ProD-byte/Roboauto/Codes/roboauto_finalv5/Claude outputs/seite.png

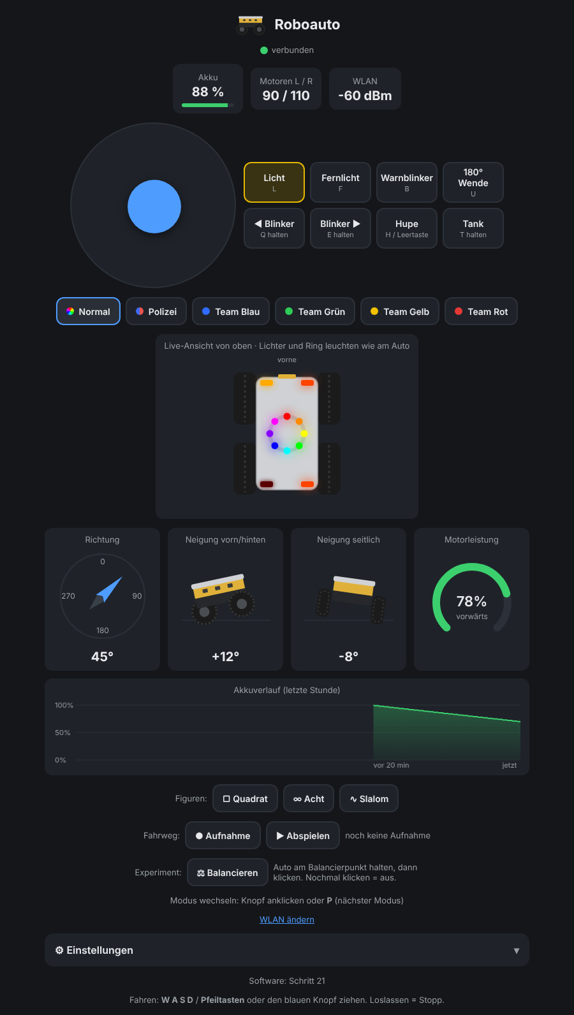
Codes/roboauto_finalv5/Claude outputs/seite.png
