ProD-byte/Roboauto/Codes/roboauto_finalv5/Claude outputs/vergleich.png

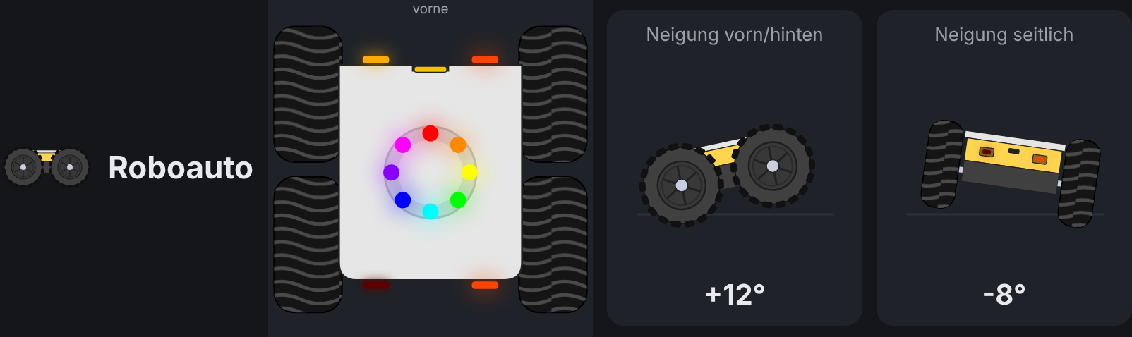
Codes/roboauto_finalv5/Claude outputs/vergleich.png
