ProD-byte/Roboauto/Codes/roboauto_pio/docs/bilder/web-jukebox.jpg

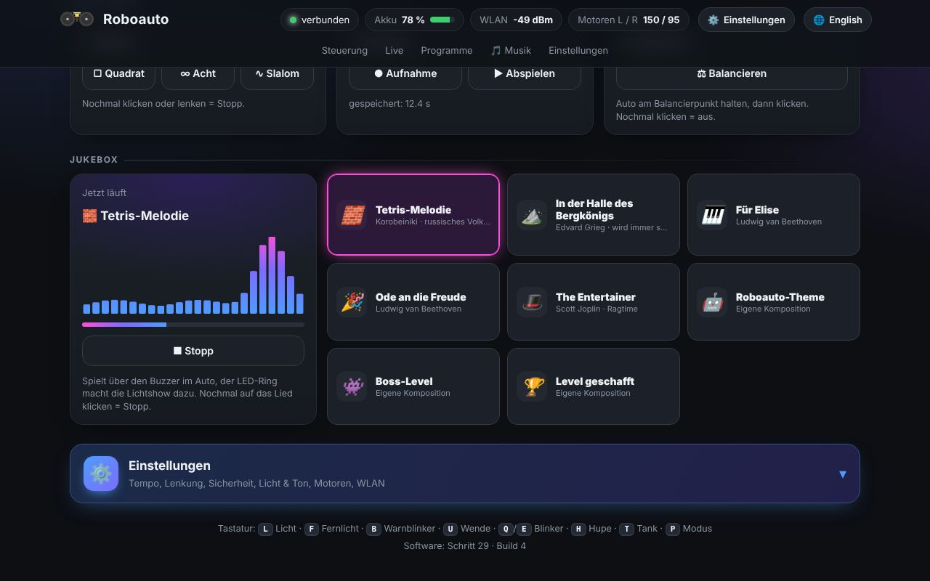
Codes/roboauto_pio/docs/bilder/web-jukebox.jpg
