ProD-byte/Roboauto/Codes/roboauto_pio/docs/bilder/web-live.jpg

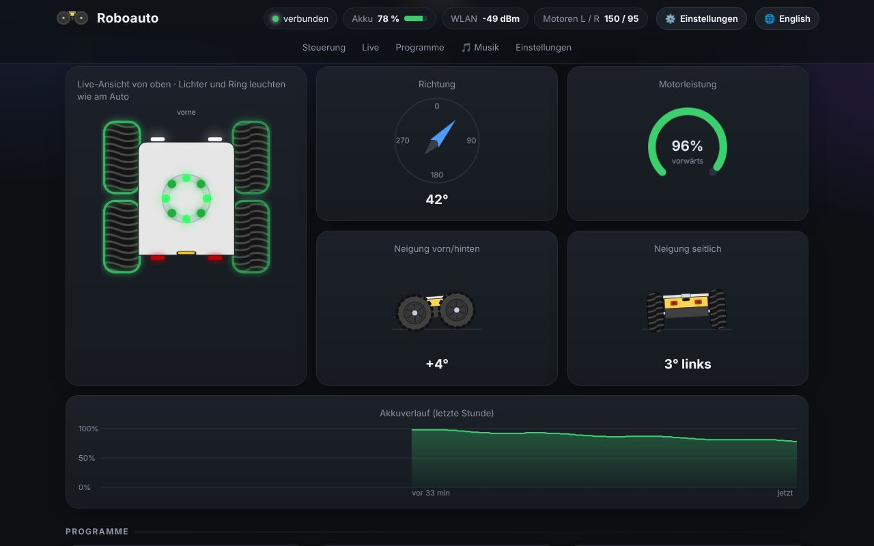
Codes/roboauto_pio/docs/bilder/web-live.jpg
