ProD-byte/Roboauto/Render1.png

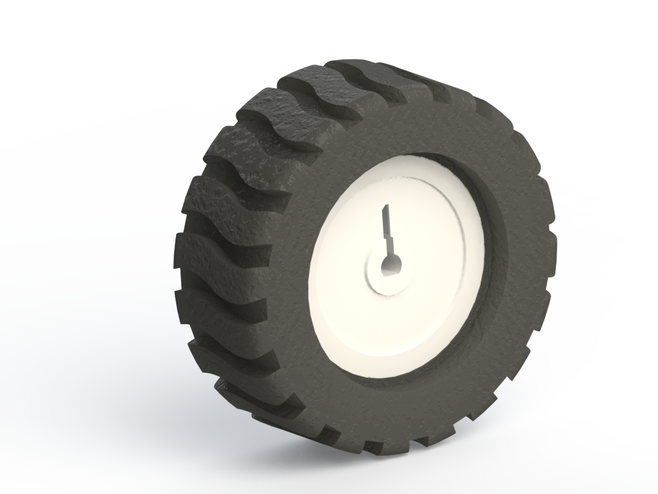
Render1.png
