ProD-byte/Roboauto/Render2.png

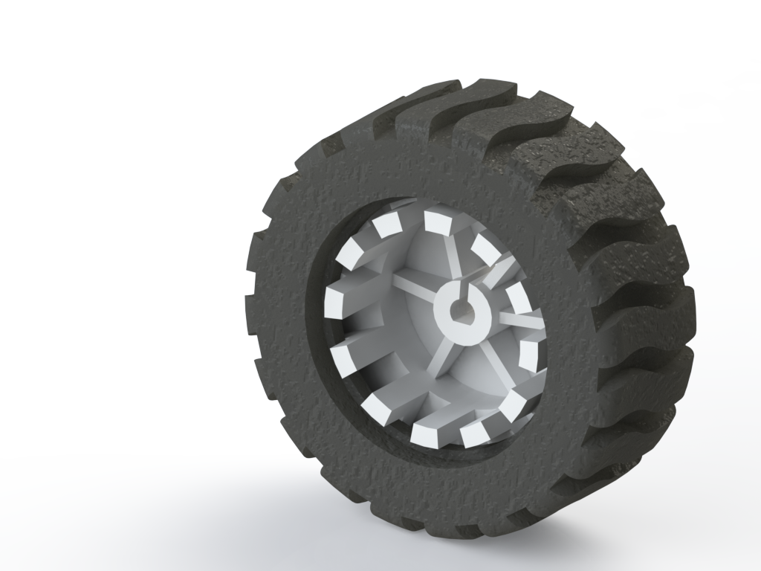
Render2.png
