ProD-byte/Roboauto/3D-Druck/alte Versionen/Roboauto Wanne.stl

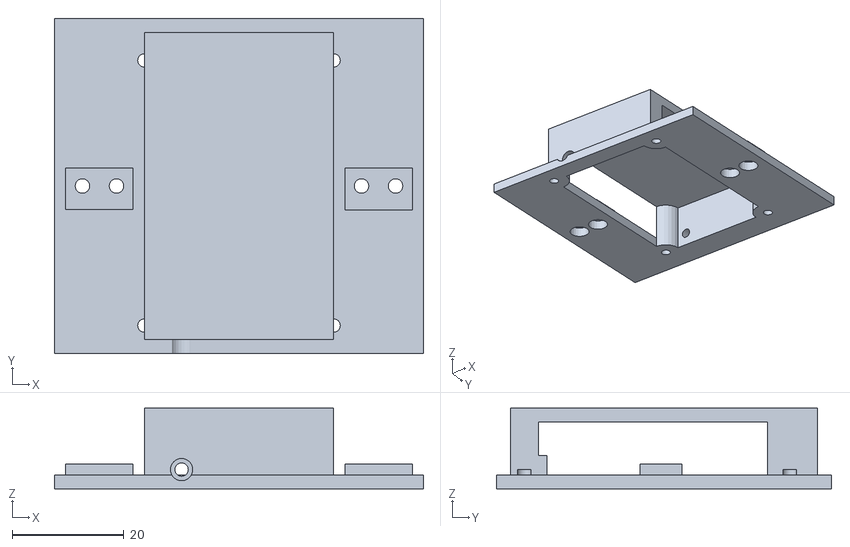
[picture p8: CAD file, 2026-10-28]
3D-Druck/alte Versionen/Roboauto Wanne.stl
66.1 x 60.0 x 14.5
