ProD-byte/Roboauto/3D-Druck/Roboauto Wanne V4.stl

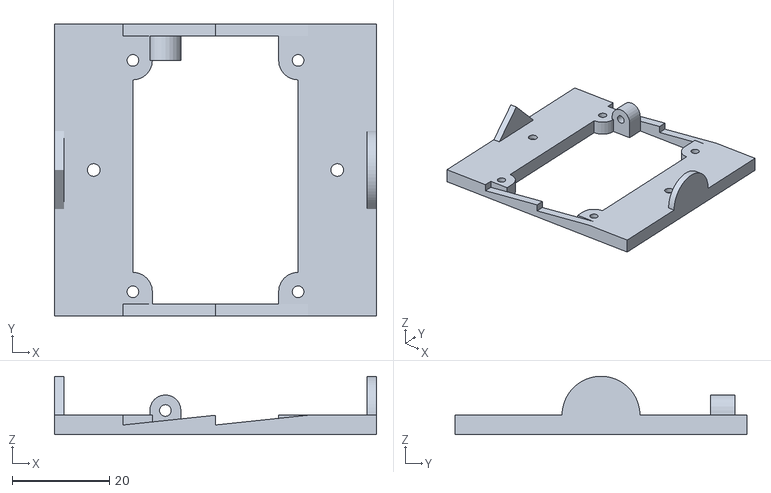
[picture p9: CAD file, 2026-10-28]
3D-Druck/Roboauto Wanne V4.stl
66.1 x 60.0 x 12.0
