ProD-byte/Roboauto/Roboauto Oberteil.stl

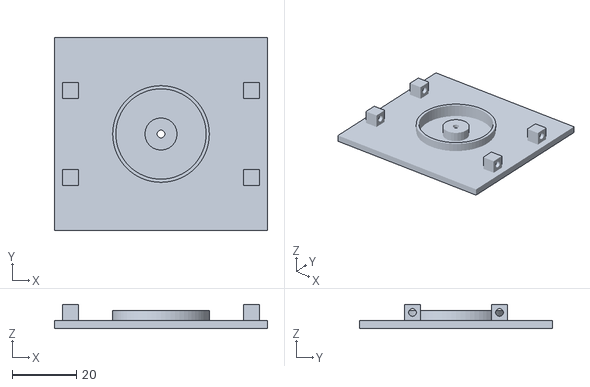
[picture p10: CAD file, 2026-10-27]
Roboauto Oberteil.stl
66.1 x 60.0 x 7.50
