ProD-byte/Roboauto/Roboauto Schalter HalterV1.stl

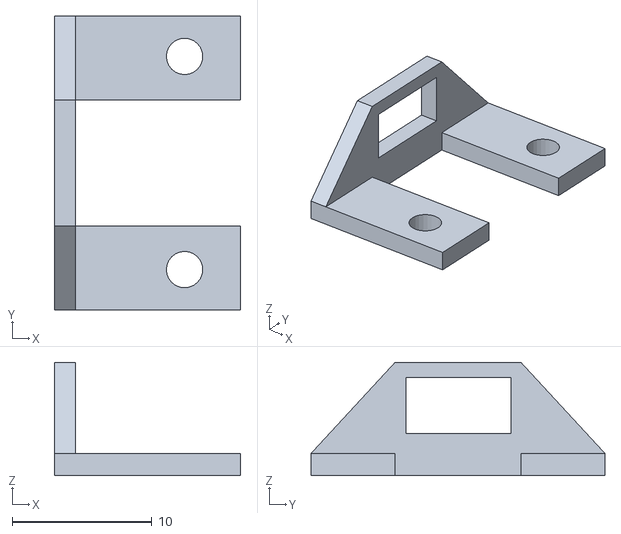
[picture p11: CAD file, 2026-10-27]
Roboauto Schalter HalterV1.stl
13.3 x 21.0 x 8.10
