ProD-byte/Roboauto/Roboauto Kugel.stl

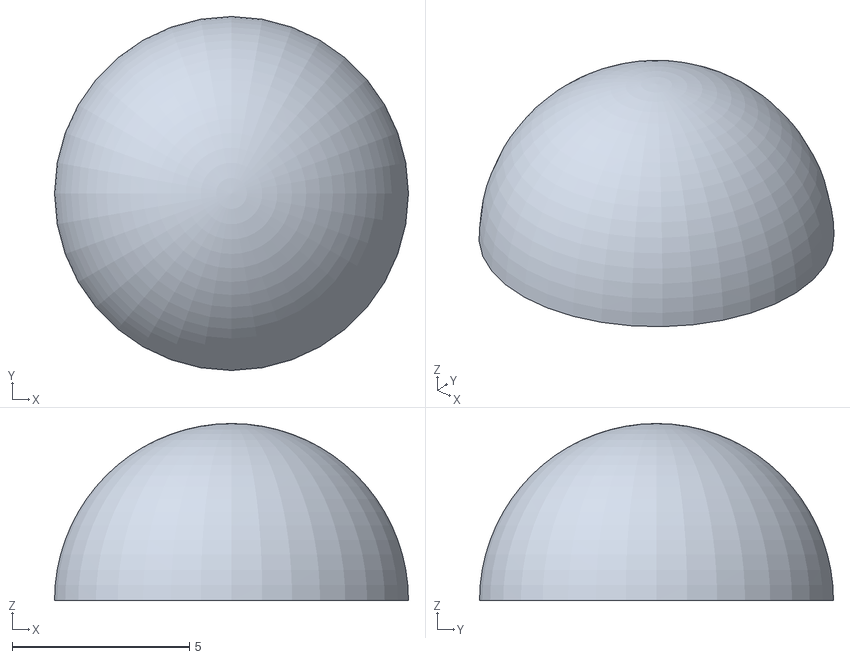
[picture p12: CAD file, 2026-10-27]
Roboauto Kugel.stl
10.0 x 10.00 x 5.00
