ProD-byte/Roboauto/Roboauto Wanne V2.stl

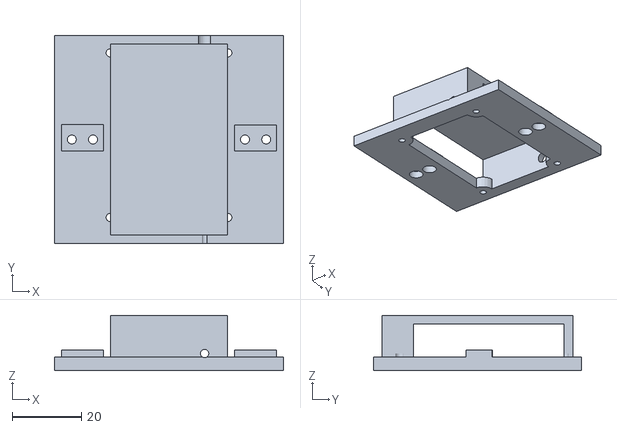
[picture p13: CAD file, 2026-10-27]
Roboauto Wanne V2.stl
66.1 x 60.0 x 16.0
