ProD-byte/Roboauto/Roboauto Ledrinhalter.stl

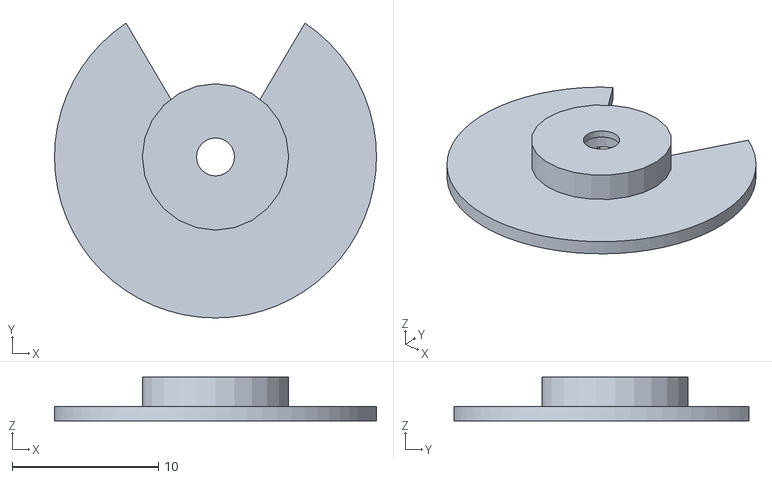
[picture p14: CAD file, 2026-10-27]
Roboauto Ledrinhalter.stl
22.0 x 20.1 x 3.00
