ProD-byte/Roboauto/Roboauto UnterteilV5.stl

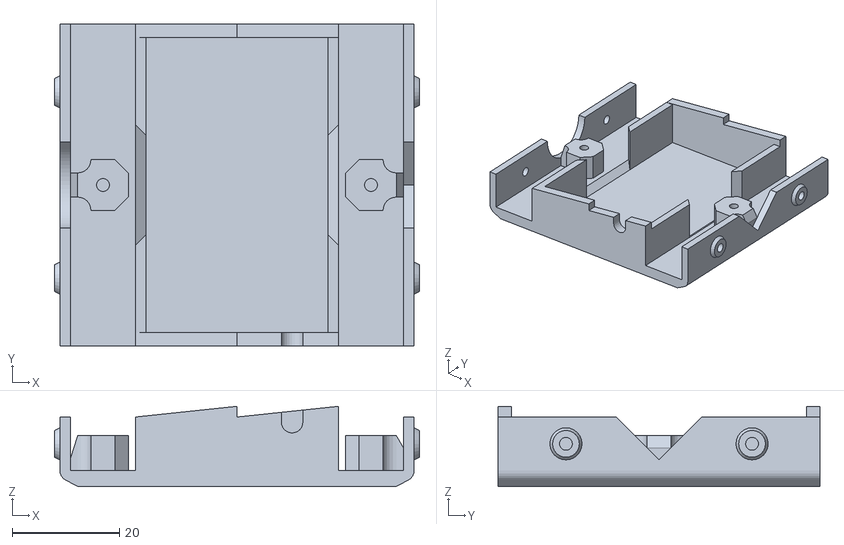
[picture p15: CAD file, 2026-10-27]
Roboauto UnterteilV5.stl
68.1 x 60.0 x 15.0
