ProD-byte/Roboauto/Roboauto Brücke.stl

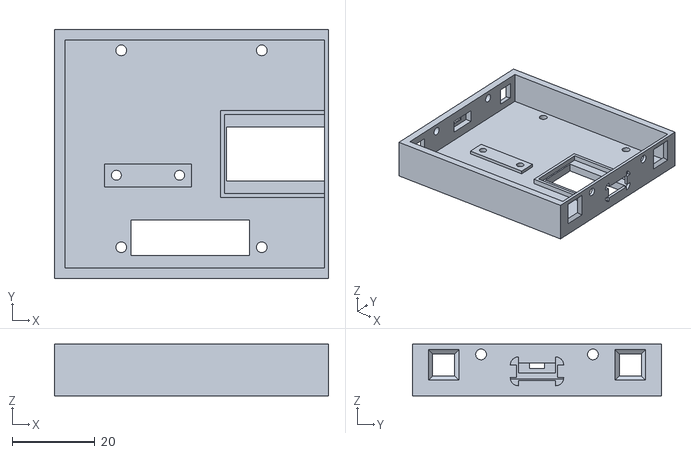
[picture p16: CAD file, 2026-10-27]
Roboauto Brücke.stl
66.1 x 60.0 x 12.5
