ProD-byte/Roboauto/Roboauto Unterteil.stl

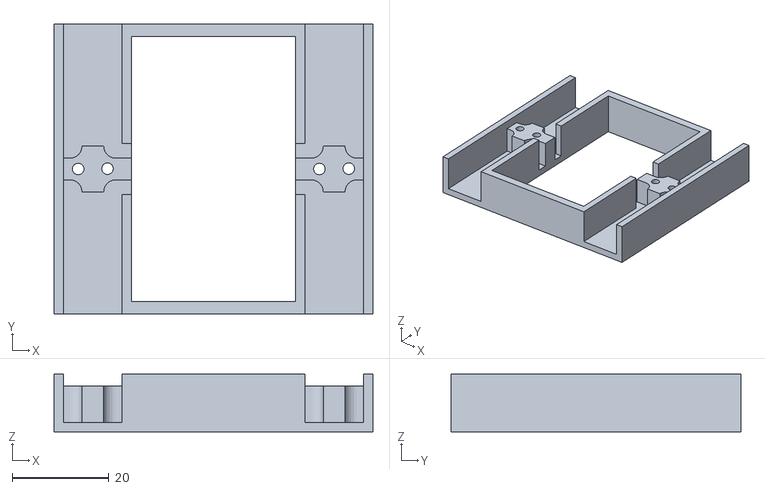
[picture p17: CAD file, 2026-10-27]
Roboauto Unterteil.stl
66.1 x 60.0 x 12.0
