ProD-byte/Roboauto/Roboauto Brücke V6.stl

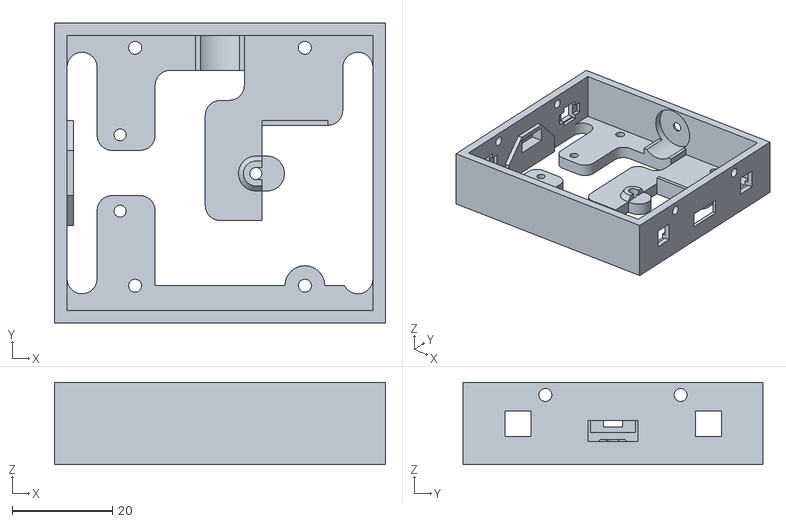
[picture p18: CAD file, 2026-10-27]
Roboauto Brücke V6.stl
66.1 x 60.0 x 16.4
