ProD-byte/Roboauto/Roboauto Brücke V2.stl

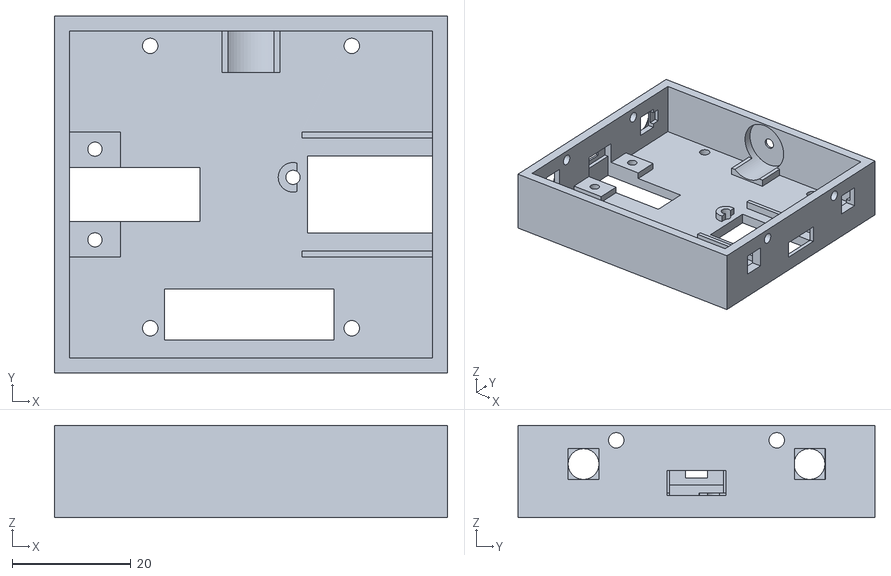
[picture p19: CAD file, 2026-10-27, an earlier design]
Roboauto Brücke V2.stl
66.1 x 60.0 x 15.5
