ProD-byte/Roboauto/(list of files, cad)

Other CAD files:
Roboauto Oberteil 32mm Ledring.stl
3D-Druck/Roboauto Brücke V6.skp
3D-Druck/Roboauto Kugel.skp
3D-Druck/Roboauto Ledrinhalter.skp
3D-Druck/Roboauto UnterteilV5.skp
3D-Druck/Roboauto WanneV4.skp
3D-Druck/alte Versionen/Roboauto Brücke V5.skp
3D-Druck/alte Versionen/Roboauto Brücke.skp
3D-Druck/alte Versionen/Roboauto Oberteil 32mm Ledring.skp
3D-Druck/alte Versionen/Roboauto Unterteil V3.skp
3D_PCB_PCB_RoboAutoPlatine_2026-09-26_2026-09-26.skp
Modell/Roboauto Version 6.skp
Platine/OBJ_PCB_RoboAutoPlatine.skp
Robo Auto Platine.skp
Roboauto Brücke V2.skp
Roboauto Brücke V3.skp
Roboauto Brücke V4.skp
Roboauto Oberteil 28mm Ledring.skp
Roboauto Oberteil 32mm Ledring V.2.skp
Roboauto Oberteil.skp
Roboauto Schalter HalterV1.skp
Roboauto Unterteil V2.skp
Roboauto Unterteil V5.skp
Roboauto Unterteil.skp
Roboauto UnterteilV4.skp
Roboauto UnterteilV5 1.skp
Roboauto Version Platine.skp
Roboauto Wanne V2.skp
Roboauto Wanne V3.skp
Roboauto Wanne.skp
