ProD-byte/Roboauto/Platine/Schaltplan_XIAO_ESP32-C6.pdf

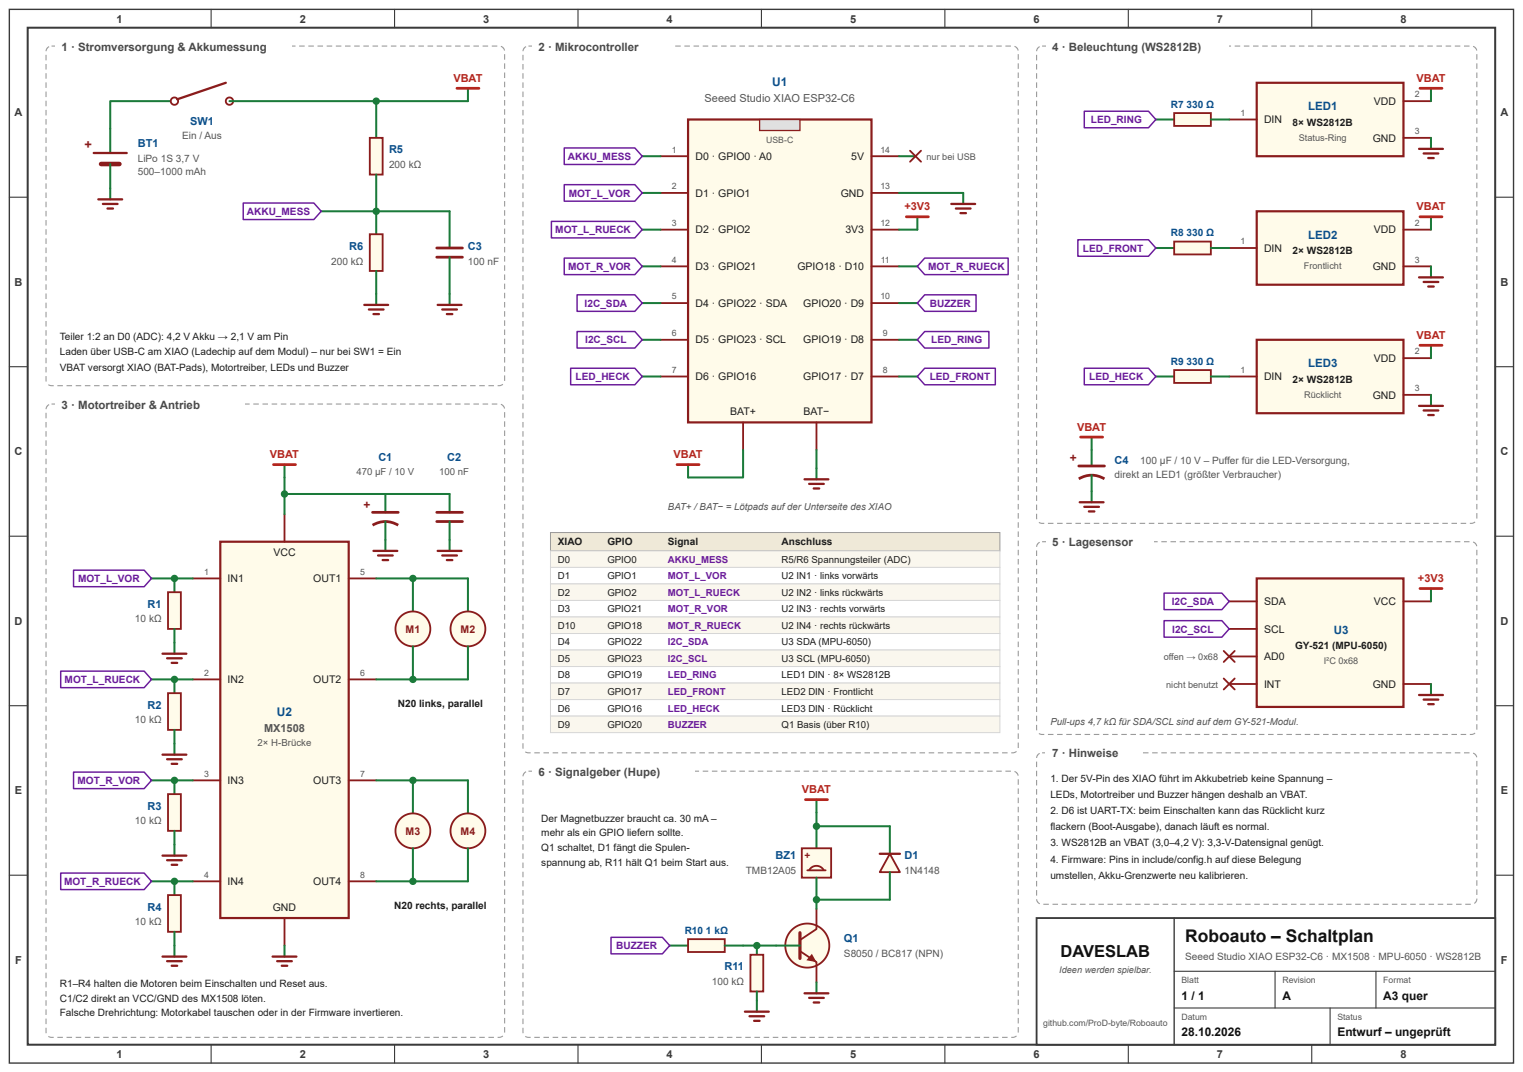
[picture p20: page 1]

Teiler 1:2 an D0 (ADC): 4,2 V Akku → 2,1 V am Pin
Laden über USB-C am XIAO (Ladechip auf dem Modul) – nur bei SW1 = Ein
VBAT versorgt XIAO (BAT-Pads), Motortreiber, LEDs und Buzzer

direkt an LED1 (größter Verbraucher)

BAT+ / BAT− = Lötpads auf der Unterseite des XIAO

Pull-ups 4,7 kΩ für SDA/SCL sind auf dem GY-521-Modul.

1. Der 5V-Pin des XIAO führt im Akkubetrieb keine Spannung –
LEDs, Motortreiber und Buzzer hängen deshalb an VBAT.
2. D6 ist UART-TX: beim Einschalten kann das Rücklicht kurz
flackern (Boot-Ausgabe), danach läuft es normal.
3. WS2812B an VBAT (3,0–4,2 V): 3,3-V-Datensignal genügt.
4. Firmware: Pins in include/config.h auf diese Belegung
umstellen, Akku-Grenzwerte neu kalibrieren.

Der Magnetbuzzer braucht ca. 30 mA –
mehr als ein GPIO liefern sollte.
Q1 schaltet, D1 fängt die Spulen-
spannung ab, R11 hält Q1 beim Start aus.

Seeed Studio XIAO ESP32-C6 · MX1508 · MPU-6050 · WS2812B

R1–R4 halten die Motoren beim Einschalten und Reset aus.
C1/C2 direkt an VCC/GND des MX1508 löten.
Falsche Drehrichtung: Motorkabel tauschen oder in der Firmware invertieren.

github.com/ProD-byte/Roboauto
