ProD-byte/Roboauto/Codes/roboauto_pio/include/config.h

#pragma once
// ============================================================
//  Zentrale Einstellungen: Pins und Fahrwerte
//
//  Board: Seeed Studio XIAO ESP32S3 Sense (Umgebung roboauto_xiao bzw. roboauto_xiao_wlan)
//
//  Pins:
//  Pin   GPIO  Funktion
//  D0    1     Motor links vor
//  D1    2     Motor links rueck
//  D2    3     Motor rechts vor
//  D3    4     Motor rechts rueck
//  D4    5     I2C SDA  (MPU6050 + Akkuwaechter)
//  D5    6     I2C SCL  (MPU6050 + Akkuwaechter)
//  D6    43    Buzzer
//  D7    44    LED-Kette DIN (Ring -> Front -> Heck)
//  D8-10 7-9   SD-Karte (SPI, auf dem Sense-Board, CS = GPIO21)
//  intern      Kamera (OV5640/OV3660/OV2640), Mikrofon (PDM: GPIO42 Takt, GPIO41 Daten)
// ============================================================

// --- Motoren (H-Bruecke) ---
constexpr int MOTOR_L_VOR    = 1;    // D0
constexpr int MOTOR_L_RUECK  = 2;    // D1
constexpr int MOTOR_R_VOR    = 3;    // D2
constexpr int MOTOR_R_RUECK  = 4;    // D3

// Drehrichtung je Motor umkehren, falls er falsch herum angeschlossen ist.
// Im Fahrtest ermittelt: der rechte Motor laeuft "verkehrt herum".
constexpr bool MOTOR_L_INVERTIERT = false;
constexpr bool MOTOR_R_INVERTIERT = false;   // neue Autos: nichts umgekehrt - per Assistent einstellen
// (Startwerte - auf der Webseite unter Einstellungen > Motoren aenderbar)
constexpr int  MOTORTEST_TEMPO = 120;     // Motortest: Staerke
constexpr unsigned long MOTORTEST_MS = 1500;   // Motortest: Dauer

// --- Weitere Pins ---
// Buzzer auf GPIO43 (TX): beim Einschalten schickt der Chip kurz seine Startmeldung dorthin,
// das gibt hoechstens ein leises Rauschen. Auf GPIO44 (RX) haetten die LEDs dabei wild geflackert.
constexpr int BUZZER_PIN     = 43;   // D6
constexpr int LED_KETTE_PIN  = 44;   // D7: alle WS2812 an EINEM Pin
constexpr int GYRO_SDA_PIN   = 5;    // D4 (I2C fuer Gyro und Akkuwaechter)
constexpr int GYRO_SCL_PIN   = 6;    // D5

// --- LED-Ring ---
constexpr int LED_RING_ANZAHL     = 8;
constexpr int LED_RING_HELLIGKEIT = 40;   // 0..255 (wie in V5)

// --- Front- und Ruecklichter (je 2 NeoPixel) ---
constexpr int FRONT_LED_ANZAHL   = 2;
constexpr int REAR_LED_ANZAHL    = 2;
// Nummern in der LED-Kette (siehe ledkette.h): 0..7 = Ring, 8..9 = Front, 10..11 = Heck.
// XIAO: Data geht in den Ring, von dessen DOUT weiter zu den Frontlichtern, von dort zu den Ruecklichtern.
constexpr int LED_KETTE_RING     = 0;                                   // erste LED des Rings
constexpr int LED_KETTE_FRONT    = LED_KETTE_RING + LED_RING_ANZAHL;    // erste Front-LED
constexpr int LED_KETTE_REAR     = LED_KETTE_FRONT + FRONT_LED_ANZAHL;  // erste Heck-LED
constexpr int LED_KETTE_ANZAHL   = LED_KETTE_REAR + REAR_LED_ANZAHL;
constexpr int LICHT_HELLIGKEIT   = 40;    // 0..255 (wie in V5)
constexpr int REAR_LED_RUECKFAHR = 1;     // diese Ruecklicht-LED wird beim Rueckwaertsfahren weiss

// Farben (wie in V5)
constexpr uint32_t FARBE_FAHRLICHT  = 0x966400;  // gelb, stromsparend
constexpr uint32_t FARBE_FERNLICHT  = 0xFFFFFF;  // weiss
constexpr uint32_t FARBE_RUECKLICHT = 0x1E0000;  // rot gedimmt
constexpr uint32_t FARBE_BREMSLICHT = 0xFF0000;  // rot hell
constexpr uint32_t FARBE_RUECKFAHR  = 0xC8C8C8;  // weiss
constexpr uint32_t FARBE_AUS        = 0x000000;

// Welche LED ist links? (0 oder 1) - die andere ist automatisch rechts
constexpr int FRONT_LED_LINKS = 0;
constexpr int REAR_LED_LINKS  = 0;

constexpr uint32_t FARBE_BLINKER    = 0xE63C00;  // orange

constexpr unsigned long BREMSLICHT_DAUER = 400;  // ms
constexpr unsigned long BLINK_TAKT       = 250;  // ms an / ms aus

// --- Hupe ---
constexpr int HUPE_FREQUENZ = 300;               // Hz (wie V5)

// --- Licht-Modi (Knoepfe in App/Webseite) ---
enum Modus { MODUS_NORMAL = 0, MODUS_POLIZEI, MODUS_BLAU, MODUS_GRUEN, MODUS_GELB, MODUS_ROT, MODUS_ANZAHL };
constexpr const char* MODUS_NAME[MODUS_ANZAHL] = { "Normal", "Polizei", "Team Blau", "Team Gruen", "Team Gelb", "Team Rot" };

// Teams: Grundfarbe (Farbton 0..65535) und wie weit der Farbton hin- und herschwingt
//                                   Normal Polizei  Blau    Gruen   Gelb   Rot
constexpr uint16_t TEAM_FARBTON[MODUS_ANZAHL] = { 0, 0,     40000,  21000,  9500,  0     };
constexpr uint16_t TEAM_SCHWANK[MODUS_ANZAHL] = { 0, 0,      4000,   7000,  2000,  2200  };
constexpr int      TEAM_HUPE_HZ[MODUS_ANZAHL] = { HUPE_FREQUENZ, 0, 600, 1200, 900, 450 };   // eigener Hupenton je Team

// --- Polizei-Modus ---
constexpr int SIRENE_MIN_HZ = 600;
constexpr int SIRENE_MAX_HZ = 1400;
constexpr unsigned long SIRENE_RUNDE_MS = 400;   // einmal hoch und runter (kleiner = hektischer)
constexpr unsigned long DOPPELKLICK_ZEIT = 350;  // ms

// --- Akku: Akkuwaechter MAX17048 am I2C-Bus (misst Spannung und Ladestand in %) ---
constexpr uint8_t AKKU_ADRESSE  = 0x36;
constexpr int AKKU_ECO_AN       = 15;   // Prozent - darunter: Eco-Modus an
constexpr int AKKU_ECO_AUS      = 20;   // Prozent - darueber: Eco-Modus wieder aus (Hysterese)
constexpr float AKKU_LAEDT_RATE = 1.0f; // %/Stunde - steigt der Ladestand schneller, haengt USB dran
constexpr unsigned long AKKU_VERLAUF_MS = 10000;   // alle 10 s ein Wert fuer das Diagramm
constexpr int AKKU_VERLAUF_PUNKTE      = 360;     // 360 x 10 s = 1 Stunde

// --- Gyroskop (MPU6050) ---
constexpr uint8_t GYRO_ADRESSE        = 0x68;
constexpr int     GYRO_KALIBRIER_MESSUNGEN = 200;   // x 5 ms = 1 Sekunde stillhalten

// --- Fahrwerte ---
constexpr int JOYSTICK_MAX    = 7;    // Joystick in App/Webseite liefert -7 ... +7
constexpr int TOTZONE         = 1;    // |Wert| <= 1 gilt als Mitte
constexpr int PWM_MAX         = 255;  // technische Obergrenze der Motoren
constexpr int MAX_TEMPO       = 128;  // Fahrgeschwindigkeit: 128 = halb so schnell wie frueher (255 = voll)
constexpr int MAX_LENKUNG     = 75;   // Lenkstaerke waehrend der Fahrt (halbiert, frueher 150)
constexpr int MAX_LENKUNG_STAND = 140; // Lenkstaerke beim Drehen auf der Stelle - braucht viel Kraft,
                                       // weil die Reifen seitlich rutschen muessen (Panzerlenkung).
                                       // Dazwischen wird fliessend uebergeblendet.


// --- Geradeauslauf mit Gyro ---
// Faehrt das Auto ohne Lenkbefehl, haelt das Gyro die Richtung.
constexpr bool  GERADEAUS_AKTIV     = true;
constexpr float GERADEAUS_KP        = 4.0f;   // Korrektur pro Grad Abweichung
constexpr float GERADEAUS_KD        = 0.5f;   // Daempfung pro Grad/s Drehrate
constexpr int   GERADEAUS_MAX_KORR  = 80;     // maximale Korrektur (von 255)

// --- 180-Grad-Wende (X doppelt klicken) ---
constexpr float WENDE_WINKEL      = 180.0f;  // Grad, links herum
constexpr int   WENDE_TEMPO_MAX   = 180;     // Drehtempo am Anfang
constexpr int   WENDE_TEMPO_MIN   = 110;     // langsamstes Drehtempo kurz vor dem Ziel
constexpr float WENDE_BREMS_BEREICH = 45.0f; // ab so vielen Grad vor dem Ziel langsamer werden
constexpr float WENDE_TOLERANZ    = 4.0f;    // Grad: so nah reicht als "fertig"
constexpr float WENDE_VORHALT     = 0.10f;   // s: so lange rollt das Auto nach dem Stopp
                                             // noch nach -> entsprechend frueher abschalten.
                                             // Schiesst es noch ueber: groesser (z.B. 0.15),
                                             // bleibt es zu frueh stehen: kleiner (z.B. 0.05)
constexpr unsigned long WENDE_MAX_ZEIT = 4000; // ms Sicherheits-Abbruch

// --- WLAN / Webseite ---
constexpr const char* WEB_NAME = "roboauto";   // Adresse im Browser: http://roboauto.local
constexpr const char* SETUP_WLAN_NAME = "Roboauto-Setup";   // eigenes WLAN zum Einrichten (ohne Passwort)

constexpr unsigned long WEB_TOTMANN_MS = 400;   // ohne neuen Fahrbefehl so lange -> Stopp
constexpr uint16_t APP_UDP_PORT = 4211;         // App schickt Fahrbefehle im WLAN per UDP (schneller als HTTP)
constexpr unsigned long WEB_GETRENNT_MS = 6000;  // so lange ohne Lebenszeichen der Seite -> "Webseite getrennt"
constexpr unsigned long WLAN_NEUVERSUCH_MS = 30000; // im Einrichtungsmodus alle 30 s erneut das Heim-WLAN probieren
constexpr unsigned long WLAN_TIMEOUT_MS = 15000;

// --- Auto-Update von GitHub (siehe autoupdate.h) ---
// Eigener Unterordner /xiao/ (frueher gab es daneben den Super Mini) - nicht aendern,
// sonst finden die Autos im Feld ihre Updates nicht mehr
constexpr const char* UPDATE_URL = "https://prod-byte.github.io/Roboauto/xiao/";   // GitHub-Pages-Adresse (mit / am Ende)
constexpr unsigned long UPDATE_ERSTE_SUCHE_MS = 60000;       // so lange nach dem WLAN-Verbinden warten, dann nachsehen
constexpr unsigned long UPDATE_INTERVALL_MS = 6UL * 3600000; // danach alle 6 Stunden
constexpr unsigned long UPDATE_RUHE_MS = 120000;             // so lange muss das Auto unbenutzt stehen, bevor es sich aktualisiert
constexpr unsigned long UPDATE_BESTAETIGEN_MS = 60000;       // so lange muss eine neue Version laufen, dann gilt sie als gut
constexpr int UPDATE_PROBE_STARTS = 3;                       // so viele Starts ohne Bestaetigung -> zurueck zur alten Version
constexpr int UPDATE_MIN_AKKU = 30;                          // Akku-Prozent, ab dem automatisch aktualisiert wird (USB immer) // so lange auf das WLAN warten, dann Fehlermeldung

// --- Figuren fahren (Quadrat, Acht, Slalom) ---
// Klein eingestellt: alle Figuren sollen in ca. 50 x 50 cm passen.
constexpr int   FIGUR_TEMPO        = 90;     // Fahrtempo auf Geraden (Quadrat)
constexpr int   FIGUR_BOGEN_TEMPO  = 75;     // Grundtempo in Boegen (Acht, Slalom)
constexpr int   FIGUR_BOGEN_LENK   = 70;     // Unterschied innen/aussen. Fast so gross wie das Bogentempo
                                             // -> inneres Rad steht fast -> sehr enge Kurve
constexpr unsigned long FIGUR_GERADE_MS = 400;   // Laenge einer Quadrat-Seite (Fahrzeit) - groesser = groesseres Quadrat
constexpr float FIGUR_VORHALT      = 0.10f;  // s Nachlauf, wie bei der Wende
constexpr unsigned long FIGUR_SEGMENT_MAX_MS = 6000;  // Sicherheits-Abbruch je Abschnitt

// --- Fahrweg aufnehmen / abspielen ---
// XIAO: mit SD-Karte wird der Fahrweg dort gespeichert (lang), ohne Karte im internen Speicher (kurz).
constexpr int           AUFNAHME_MAX_INTERN    = 500;     // so viele Lenk-/Gas-Aenderungen passen in den internen Speicher
constexpr unsigned long AUFNAHME_MAX_MS_INTERN = 120000;  // maximal 2 Minuten
constexpr int           AUFNAHME_MAX_EINTRAEGE = 5000;    // mit SD-Karte
constexpr unsigned long AUFNAHME_MAX_MS        = 600000;  // mit SD-Karte: 10 Minuten

// --- Balancieren (auf zwei Raedern, Schnauze hoch) ---
// Einschalten: Auto am "schwerelosen" Punkt halten, dann Knopf "Balancieren" in App/Webseite
// oder Knopf "Balancieren" auf der Webseite. Die aktuelle Neigung wird zum Balancierpunkt.
constexpr int   BALANCE_RICHTUNG   = 1;      // auf -1 stellen, falls das Auto in die Kipprichtung WEGfaehrt
constexpr float BALANCE_KP         = 18.0f;  // PWM pro Grad Neigung (Hauptwert)
constexpr float BALANCE_KD         = 0.8f;   // PWM pro Grad/s Kippgeschwindigkeit (Daempfung)
constexpr float BALANCE_KI         = 0.0f;   // gegen langsames Wegdriften (erst spaeter erhoehen)
constexpr int   BALANCE_MIN_PWM    = 30;     // Motoren-Totzone ueberwinden
constexpr int   BALANCE_MAX_PWM    = 180;    // Obergrenze (weniger Stromspitzen)
constexpr int   BALANCE_MAX_SPRUNG = 20;     // max. PWM-Aenderung pro 5 ms (sanfte Richtungswechsel)
constexpr float BALANCE_UMFALL_WINKEL = 35.0f;  // mehr Abweichung = umgefallen -> Motoren aus
constexpr float BALANCE_FAHR_WINKEL   = 3.0f;   // Joystick vor/zurueck verschiebt den Sollwinkel max. so weit
constexpr int   BALANCE_LENKUNG       = 60;     // Joystick links/rechts beim Balancieren

// --- Crash- und Umkipp-Erkennung ---
constexpr bool  CRASH_AKTIV          = true;
constexpr float CRASH_STOSS_G        = 2.5f;   // waagerechter Stoss in g = Aufprall (kleiner = empfindlicher)
constexpr int   CRASH_MESSUNGEN      = 3;      // so viele Messungen hintereinander (je 5 ms) ueber der Grenze
constexpr unsigned long CRASH_ANFAHR_MS = 400; // nach Anfahren/Richtungswechsel so lange keinen Aufprall pruefen
constexpr unsigned long CRASH_SPERRE_MS = 1500; // nach einem Aufprall so lange nicht fahren
constexpr float UMGEKIPPT_AUFRECHT   = 0.4f;   // darunter (ca. 65 Grad Schraeglage) gilt als umgekippt
constexpr unsigned long UMGEKIPPT_MS = 600;    // so lange schraeg = wirklich umgekippt (kein Hopser)

// --- Medien-Server (eigener Webserver neben der Steuerung, jede Anfrage in eigener Aufgabe) ---
//   http://roboauto.local:81/stream    Live-Video
//   http://roboauto.local:81/bild      Einzelbild
//   http://roboauto.local:81/ton       Live-Ton vom Mikrofon
//   http://roboauto.local:81/dateien   Inhalt der SD-Karte,  /datei?pfad=...  herunterladen
constexpr int  MEDIEN_PORT        = 81;

// --- Kamera (Sense-Board) ---
constexpr int  KAMERA_JPEG_QUALI  = 12;          // 10 = schoen, 20 = klein und schnell
constexpr unsigned long KAMERA_STREAM_MS = 45;   // hoechstens ca. 22 Bilder/s - die OV5640 schafft bei 640x480 gut 20
// Hoert jemand den Live-Ton, hat der Vorrang: das Video teilt sich die (knappe) Funkstrecke sonst so
// gierig, dass Tonstuecke verloren gehen - das klingt nach Knacken/"Schnurren".
constexpr unsigned long KAMERA_STREAM_MIT_TON_MS = 83;   // dann hoechstens ca. 12 Bilder/s
constexpr bool KAMERA_DREHEN      = false;       // Bild steht auf dem Kopf? -> true (dreht um 180 Grad)
// So viel wird das Bild auf der Webseite im Uhrzeigersinn gedreht (0/90/180/270). Der Sensor kann nur
// spiegeln, nicht um 90 Grad drehen - das macht der Browser. 0 passt fuer die OV5640 im V7
// (die alte OV3660 brauchte 270 = 90 Grad nach links). Auf der Webseite unter Kamera mit "Drehen"
// aenderbar, wird im Auto gespeichert - gilt nur, solange noch nichts gespeichert ist.
constexpr int  KAMERA_DREHUNG     = 0;

// --- Mikrofon (PDM, Sense-Board) ---
constexpr int  MIKRO_TAKT_PIN     = 42;
constexpr int  MIKRO_DATEN_PIN    = 41;
constexpr int  MIKRO_RATE         = 16000;       // Abtastrate in Hz
constexpr int  MIKRO_VERSTAERKUNG = 4;           // das Mikro ist leise -> digital verstaerken
constexpr int  KLATSCH_SCHWELLE   = 60;          // Pegel 0..100: so laut = ein Klatscher
constexpr unsigned long KLATSCH_PAUSE_MS = 120;  // so lange leise zwischen zwei Klatschern
constexpr unsigned long KLATSCH_FENSTER_MS = 700;// 2x klatschen innerhalb dieser Zeit = Licht an/aus

// --- SD-Karte (Sense-Board) ---
constexpr int SD_CS_PIN   = 21;
constexpr int SD_SCK_PIN  = 7;
constexpr int SD_MISO_PIN = 8;
constexpr int SD_MOSI_PIN = 9;

// --- Lernen: Fahrdaten + Kamerabilder auf die SD-Karte schreiben ---
// Jede Fahrt kommt in einen eigenen Ordner /lernen/fahrt_0001/ mit daten.csv und Bildern.
// Aus diesen Daten kann spaeter (am PC) ein Modell lernen, wie man faehrt.
constexpr unsigned long LERNEN_DATEN_MS = 100;   // 10 Zeilen pro Sekunde in daten.csv
constexpr unsigned long LERNEN_BILD_MS  = 250;   // 4 Bilder pro Sekunde

// Name fuer Bluetooth und eigenes WLAN, dahinter kommt die Chip-Nummer: z. B. "Roboauto-3F2A"
// (so lassen sich mehrere Autos am selben Ort auseinanderhalten - die App sucht alles, was mit "Roboauto" anfaengt).
// Ein eigener Name aus den Einstellungen ersetzt die Chip-Nummer: "Roboauto-Blitz".
constexpr const char* AUTO_NAME_ANFANG = "RoboautoXiao";
constexpr const char* BOARD_NAME = "xiao";   // fuer /info: welche Oberflaeche die App zeigt (mit Kamera)
