ProD-byte/Roboauto/Codes/roboauto_pio/src/main.cpp

// ============================================================
//  ROBOAUTO - Neuaufbau mit PlatformIO
//  Schritt 1: Bluetooth-Verbindung + Fahren
//  Schritt 2: LED-Ring (blau = warten, Regenbogen = verbunden) + Buzzer
//  Schritt 3: Front-, Rueck-, Brems- und Rueckfahrlicht
//  Schritt 4: Blinker, Warnblinker, Hupe
//  Schritt 6: Akkuanzeige (Start halten) + Eco-Modus
//  Schritt 7: Gyroskop + Geradeauslauf + 180-Grad-Wende (X doppelt)
//  Schritt 10: halbe Geschwindigkeit (MAX_TEMPO in config.h)
//  Schritt 11: WLAN + Web-Steuerung (http://roboauto.local) + Updates ueber WLAN
//  Schritt 12: Polizei-Modus (Select / Knopf), Sirene auf X
//  Schritt 13: Team Blau / Gruen / Gelb / Rot (Ring-Farbspiel + eigener Hupenton)
//  Schritt 14: WLAN-Einrichtung per Handy (eigenes WLAN "Roboauto-Setup")
//  Schritt 15: Crash- und Umkipp-Erkennung (Alarm, Warnblinker, Motoren aus)
//  Schritt 16: Figuren fahren (Quadrat, Acht, Slalom) - Start 2x / Webseite
//  Schritt 17: Fahrweg aufnehmen/abspielen (Start+Viereck / Start+Kreis / Webseite)
//  Balancieren (Experiment): Knopf auf der Webseite
//  Schritt 40: eigene Roboauto-App statt Dabble (Bluetooth + WLAN, gleiche Oberflaeche)
//
//  Board: XIAO ESP32S3 Sense. Dazu:
//  - alle LEDs an einem Pin (Ring -> Front -> Heck), siehe ledkette.h
//  - Akku ueber MAX17048 am I2C-Bus
//  - Kamera: Live-Video im Browser, Fotos auf die SD-Karte
//  - Mikrofon: Live-Ton, Lautstaerke, Doppelklatschen = Licht an/aus
//  - SD-Karte: "Lernen" schreibt Fahrdaten + Bilder mit, lange Fahrweg-Aufnahmen
// ============================================================
#include <Arduino.h>
#include <BLEDevice.h>

#include "config.h"
#include "app_ble.h"
#include "antrieb.h"
#include "ledring.h"
#include "buzzer.h"
#include "lichter.h"
#include "akku.h"
#include "gyro.h"
#include "autoupdate.h"
#include "musik.h"
#include "web.h"
#include "sicherheit.h"
#include "figuren.h"
#include "aufnahme.h"
#include "balance.h"
#include "einstellungen.h"
#include "neustart.h"
#include "zeit.h"
#include "ledkette.h"
#include "kamera.h"
#include "mikro.h"
#include "karte.h"
#include "lernen.h"
#include "video.h"

static bool verbunden = false;     // App ODER Webseite (fuer Ring, Lichter, Fahren)
static bool bleVorher = false;
static bool webVorher = false;

// Licht-Modus (siehe enum Modus in config.h): Knoepfe in App/Webseite
static int  modus = MODUS_NORMAL;

// Gyro neu kalibrieren: alles anhalten, dann im Hintergrund messen
static void kalibrierungStarten() {
  if (!gyroBereit()) { buzzerWarnung(); return; }
  figurAbbrechen();
  balanceAus();
  if (abspielenLaeuft()) abspielenUmschalten();
  antriebStopp();
  buzzerEin();
  gyroKalibrierungStarten();
}

static void setzeModus(int neu) {
  modus = (neu + MODUS_ANZAHL) % MODUS_ANZAHL;
  buzzerTick();
  Serial.printf(">> Modus: %s\n", MODUS_NAME[modus]);
}
static bool klatschAn = false;     // Doppelklatschen schaltet das Licht (Knopf auf der Webseite)

// Fragt den BLE-Server, ob die App per Bluetooth verbunden ist
static bool handyVerbunden() {
  BLEServer* server = BLEDevice::getServer();
  return server != nullptr && server->getConnectedCount() > 0;
}

void setup() {
  Serial.begin(115200);
  // WICHTIG: Ist das USB-Kabel gesteckt, aber kein Monitor offen, liest niemand
  // die Debug-Ausgaben. Ohne diese Zeile wartet der ESP dann bei jeder Ausgabe
  // und alles laeuft wie in Zeitlupe. 0 = nie warten, notfalls Text verwerfen.
  Serial.setTxTimeoutMs(0);
  delay(1000);

  neustartMerken();                       // Grund des Starts merken, Abstuerze mitzaehlen (Webseite: System)
  zeitStarten();                          // Zeitzone fuer Datum/Uhrzeit in Dateinamen
  autoUpdateStart();                      // nach einem Auto-Update: startet die neue Version sauber? sonst zurueck
  einstellungenLaden();                   // gespeicherte Einstellungen (vor allem anderen)
  antriebStarten();
  ringStarten();
  buzzerStarten();
  buzzerStartklang(ringStartanimation);    // "Hochfahren": Startklang + Ring-Animation
  lichtStarten();
  if (gyroStarten()) gyroKalibrieren();   // Auto beim Einschalten 1 s still stehen lassen
  akkuStarten();                          // nach dem Gyro: beim XIAO teilen sich beide den I2C-Bus
  karteStarten();                         // SD-Karte (vor aufnahmeStarten - der Fahrweg liegt dort)
  kameraStarten();
  mikroStarten();
  lernenStarten();
  videoStarten();                         // Video-Aufnahme auf die SD-Karte
  appBleStarten();                        // Bluetooth fuer die Roboauto-App
  webStarten();                           // WLAN + Webseite (oder Einrichtungs-WLAN)
  aufnahmeStarten();                      // gespeicherten Fahrweg laden

  Serial.println();
  Serial.println("=== Roboauto XIAO ESP32S3 Sense - Kamera, Mikrofon, SD-Karte, eine LED-Kette ===");
  // "intern" ist der knappe Speicher fuer WLAN, Bluetooth, Kamera und Webserver - unter ca. 20 KB wird es eng
  Serial.printf("PSRAM: %u KB frei, intern: %u KB frei, Flash: %u MB\n", (unsigned)(ESP.getFreePsram() / 1024),
                (unsigned)(heap_caps_get_free_size(MALLOC_CAP_INTERNAL) / 1024), (unsigned)(ESP.getFlashChipSize() / (1024 * 1024)));
  Serial.printf("Grund fuer Neustart: %d (1=Einschalten, 4=Absturz, 6=Watchdog, 9=Spannungseinbruch) - Abstuerze bisher: %d\n",
                neustartGrund(), neustartAbstuerze());
}

void loop() {
  appBleUpdate();

  akkuUpdate();
  gyroUpdate();
  webUpdate();

  // --- WLAN-Ergebnis nach dem Start anzeigen ---
  switch (webEreignis()) {
    case 1: ringSignal(0x00B4FF); buzzerWlanOk();     break;   // tuerkis + drei steigende Blips
    case 2: ringSignal(0xFF2000); buzzerWlanFehler(); break;   // rot + tiefer Ton
    case 3: ringSignal(0xFF8000); buzzerWarnung();    break;   // orange: Einrichtung offen
  }
  static bool rueckfallGemeldet = false;
  if (autoUpdateZurueckgesetzt() && !rueckfallGemeldet && millis() > 3000) {   // Auto-Update ging schief -> alte Version laeuft
    rueckfallGemeldet = true;
    ringSignal(0xFF8000); buzzerWarnung();
  }

  // --- Verbindung ueberwachen ---
  // App (Bluetooth) und Webseite getrennt ueberwachen.
  // Nur die Bluetooth-Verbindung spielt die Verbinden-/Trennen-Melodie - die Webseite meldet sich
  // nur im Monitor, damit es nicht staendig piept, wenn der Browser kurz haengt.
  bool ble = handyVerbunden();
  bool web = webVerbunden();
  if (ble != bleVorher) {
    bleVorher = ble;
    Serial.println(ble ? ">> Handy (Bluetooth) verbunden" : ">> Handy (Bluetooth) getrennt");
    if (ble) buzzerVerbunden(); else buzzerGetrennt();
  }
  if (web != webVorher) {
    webVorher = web;
    Serial.println(web ? ">> Webseite verbunden" : ">> Webseite getrennt (kein Lebenszeichen)");
  }
  verbunden = ble || web;

  // --- Fahren (nur mit Verbindung, sonst Stopp) ---
  // App und Webseite schicken dieselben Befehle (Bluetooth, WLAN oder Browser)
  int x = 0, y = 0;
  int wt = webTasten();                                  // gehaltene Tasten in App/Webseite
  bool startTaste = wt & WEB_TANK;
  if (webFaehrt()) {
    x = webX();
    y = webY();
  }

  // --- Gyro-Kalibrierung im Hintergrund ---
  if (gyroKalibriertGerade()) { x = 0; y = 0; }      // waehrenddessen nicht fahren
  ringKalibrierung(gyroKalibriertGerade() ? gyroKalibrierFortschritt() : -1);
  switch (gyroKalibrierErgebnis()) {
    case 1: buzzerWlanOk(); ringSignal(0x40FF80); break;   // fertig: gruenes Signal
    case 2: buzzerWarnung(); ringSignal(0xFF4000); break;  // bewegt: orange, alte Werte bleiben
  }
  if (!verbunden) balanceAus();

  // --- Fahrweg aufnehmen / abspielen (ersetzt beim Abspielen x/y) ---
  if (!verbunden && abspielenLaeuft()) abspielenUmschalten();   // Verbindung weg -> stoppen
  aufnahmeUpdate(x, y);
  ringAufnahme(aufnahmeLaeuft() ? 1 : abspielenLaeuft() ? 2 : 0);

  // --- Crash- und Umkipp-Erkennung ---
  bool stickInMitte = abs(x) <= TOTZONE && abs(y) <= TOTZONE;
  // Beim Balancieren steht das Auto schraeg -> Umkipp-Erkennung waere falsch; Balance hat eigene Umfall-Abschaltung
  switch (sicherheitUpdate(verbunden && !balanceAktiv(), stickInMitte, antriebLinks(), antriebRechts())) {
    case 1:                                   // Aufprall
    case 2:                                   // umgekippt
      antriebStopp();
      buzzerAlarm();
      lichtBefehl(WARNBLINKER_AUTO_AN);
      break;
    case 3:                                   // wieder aufgestellt / fahrbereit
      lichtBefehl(WARNBLINKER_AUTO_AUS);
      break;
  }
  ringAlarm(!sicherheitFahrenErlaubt());

  // Figur laeuft? Joystick bewegen, Verbindung weg oder Alarm -> abbrechen
  if (figurAktiv() && (!stickInMitte || !verbunden || !sicherheitFahrenErlaubt())) {
    figurAbbrechen();
    Serial.println(">> Figur abgebrochen");
  }

  if (balanceAktiv() && figurAktiv()) figurAbbrechen();
  if (antriebTestSeite() >= 0 && !stickInMitte) antriebStopp();   // Joystick bricht den Motortest ab
  if (!verbunden || !sicherheitFahrenErlaubt()) antriebStopp();
  else if (antriebTestSeite() >= 0)              antriebTestUpdate();
  else if (balanceAktiv())                       balanceUpdate(x, y);
  else if (figurAktiv())                         figurUpdate();
  else                                           antriebFahren(x, y);

  // --- Lernen: aktuelle Werte an die SD-Aufgabe geben (schreibt nur, wenn Lernen an ist) ---
  lernenDaten({ x, y, antriebLinks(), antriebRechts(), gyroDrehrate(), gyroWinkel(),
                -gyroNeigungY(), gyroNeigungX(), akkuUsb() ? -1 : akkuProzent(), mikroPegel(),
                modus, lichtIstAn() });

  // --- LED-Ring: Verbindungsstatus ---
  // Regenbogen = App per Bluetooth, tuerkiser Komet = ueber den Router, violetter Komet = direkt im WLAN des Autos,
  // blau = niemand. Tank-Knopf = Tankanzeige
  RingQuelle quelle = ble ? RING_APP : !web ? RING_NIEMAND : webUeberAutoWlan() ? RING_AUTOWLAN : RING_WEB;
  static RingQuelle quelleVorher = RING_NIEMAND;
  if (quelle != quelleVorher) {                      // neu verbunden / Weg gewechselt: kurzes Farbsignal, auch bei Polizei/Team
    ringVerbunden(quelle);
    quelleVorher = quelle;
  }
  webSetzeModus(modus);

  ringEinrichtung(webEinrichtung());                 // orange atmend = WLAN einrichten
  ringMusik(musikNummer() >= 0, musikTon(), musikNotenNummer());
  // Akku laedt (Akkuwaechter misst) und das Auto steht seit 3 s: Ring zeigt den Ladestand
  static unsigned long zuletztBewegt = 0;
  if (antriebLinks() != 0 || antriebRechts() != 0) zuletztBewegt = millis();
  bool laden = akkuUsb() && akkuWert() > 0 && millis() - zuletztBewegt > 3000;
  ringLaden(laden ? akkuProzent() : -1);
  ringStatus(quelle, startTaste, akkuUsb() ? -1 : akkuProzent(), modus);

  // --- Einmal-Aktionen von der Webseite ---
  int aktion = webAktion();
  switch (aktion) {
    case WEB_AKTION_LICHT:        lichtBefehl(LICHT_UMSCHALTEN);       break;
    case WEB_AKTION_FERNLICHT:    lichtBefehl(FERNLICHT_UMSCHALTEN);   break;
    case WEB_AKTION_WARN:         lichtBefehl(WARNBLINKER_UMSCHALTEN); break;
    case WEB_AKTION_WENDE:        if (!antriebWendeStarten()) buzzerWarnung(); break;
    case WEB_AKTION_MODUS_WEITER: setzeModus(modus + 1); break;
    default:
      if (aktion == WEB_AKTION_KALIBRIEREN) kalibrierungStarten();
      if (aktion == WEB_AKTION_MUSIK_STOPP) musikStopp();
      if (aktion >= WEB_AKTION_MUSIK && aktion < WEB_AKTION_MUSIK + musikAnzahl()) musikStarten(aktion - WEB_AKTION_MUSIK);
      if (aktion == WEB_AKTION_MOTORTEST || aktion == WEB_AKTION_MOTORTEST + 1) {
        if (figurAktiv()) figurAbbrechen();
        if (abspielenLaeuft()) abspielenUmschalten();
        balanceAus();
        antriebTestStarten(aktion - WEB_AKTION_MOTORTEST);
      }
      if (aktion == WEB_AKTION_BALANCE) { if (balanceUmschalten()) buzzerEin(); else buzzerAus(); }
      if (aktion == WEB_AKTION_AUFNAHME)  aufnahmeUmschalten();
      if (aktion == WEB_AKTION_ABSPIELEN) abspielenUmschalten();
      if (aktion == WEB_AKTION_LERNEN) {
        if (!karteDa())               buzzerWarnung();
        else if (lernenUmschalten())  buzzerEin();
        else                          buzzerAus();
      }
      if (aktion == WEB_AKTION_FOTO) { if (lernenFoto()) buzzerTick(); else buzzerWarnung(); }
      if (aktion == WEB_AKTION_KLATSCHEN) {
        klatschAn = !klatschAn && mikroDa();
        if (klatschAn) buzzerEin(); else buzzerAus();
        Serial.println(klatschAn ? ">> Klatschsteuerung AN (2x klatschen = Licht)" : ">> Klatschsteuerung AUS");
      }
      if (aktion >= WEB_AKTION_FIGUR && aktion < WEB_AKTION_FIGUR + FIGUR_ANZAHL) {
        if (figurAktiv()) figurAbbrechen();                 // nochmal klicken = stoppen
        else if (figurStarten(aktion - WEB_AKTION_FIGUR)) buzzerEin();
        else buzzerWarnung();
      }
      if (aktion >= WEB_AKTION_MODUS_DIREKT && aktion < WEB_AKTION_MODUS_DIREKT + MODUS_ANZAHL)
        setzeModus(aktion - WEB_AKTION_MODUS_DIREKT);
      break;
  }
  webSetzeModus(modus);

  // --- Mikrofon: zweimal klatschen = Licht an/aus (nur wenn eingeschaltet) ---
  // Waehrend Musik oder Hupe laeuft, hoert das Mikro den Buzzer -> dann nicht auswerten
  bool klatsch = mikroDoppelKlatsch();
  if (klatsch && klatschAn && musikNummer() < 0 && !(wt & WEB_HUPE)) lichtBefehl(LICHT_UMSCHALTEN);
  webSetzeKlatschen(klatschAn);

  // Hupe-Knopf: Polizei = Sirene + Frontblitzer, Teams = eigener Hupenton
  bool hupeGedrueckt = wt & WEB_HUPE;
  if (modus == MODUS_POLIZEI) { buzzerHupe(false); buzzerSirene(hupeGedrueckt); }
  else                        { buzzerSirene(false); buzzerHupe(hupeGedrueckt, TEAM_HUPE_HZ[modus]); }
  lichtBlitzer(modus == MODUS_POLIZEI && hupeGedrueckt);
  musikUpdate();
  buzzerUpdate();

  // --- Lichter, Blinker, Warnblinker ---
  LichtTasten tasten = {};
  if (wt & WEB_BLINK_L) tasten.viereck = true;   // Blinker von App/Webseite (gehalten)
  if (wt & WEB_BLINK_R) tasten.kreis   = true;
  // Beim Balancieren zappeln die Motoren staendig -> fuer Brems-/Rueckfahrlicht als 'steht' werten
  lichtDisco(musikNummer() >= 0 && einst().disco, musikTon(), musikNotenNummer(), musikViertel());
  lichtUpdate(verbunden, tasten, balanceAktiv() ? 0 : antriebLinks(), balanceAktiv() ? 0 : antriebRechts(), akkuEco());

  // --- Auto-Update: nur wenn das Auto eine Weile unbenutzt steht und der Akku reicht ---
  static unsigned long letzteNutzung = 0;
  if (ble || webFaehrt() || antriebLinks() != 0 || antriebRechts() != 0 || figurAktiv() || balanceAktiv() ||
      musikNummer() >= 0 || aufnahmeLaeuft() || abspielenLaeuft() || !sicherheitFahrenErlaubt()
      || lernenAktiv() || kameraZuschauer() > 0 || mikroZuhoerer() > 0
     )
    letzteNutzung = millis();
  bool ruhig = millis() - letzteNutzung > UPDATE_RUHE_MS && (akkuUsb() || akkuProzent() >= UPDATE_MIN_AKKU);
  autoUpdateLoop(webWlanDa(), ruhig);

  // --- Debug-Ausgabe alle 250 ms ---
  static unsigned long letzteAusgabe = 0;
  if (millis() - letzteAusgabe >= 250) {
    letzteAusgabe = millis();
    Serial.printf("verbunden=%d  x=%d y=%d  links=%d rechts=%d  akku=%d%s  gyro=%6.1f Grad/s  winkel=%6.1f Grad  korr=%d  stoss=%.1fg\n",
                  verbunden, x, y, antriebLinks(), antriebRechts(),
                  akkuWert(), akkuEco() ? " ECO" : "",
                  gyroDrehrate(), gyroWinkel(), antriebKorrektur(), sicherheitMaxStoss());
  }

  ketteZeigen();   // was Ring und Lichter in diesem Durchlauf geaendert haben, an die LEDs schicken
}
