ProD-byte/Roboauto/Codes/roboauto_pio/src/web.cpp

#include <Arduino.h>
#include <WiFi.h>
#include <Wire.h>
#include <WebServer.h>
#include <ESPmDNS.h>
#include <ArduinoOTA.h>
#include <DNSServer.h>
#include <Preferences.h>
#include "config.h"
#include "autoupdate.h"
#include "musik.h"
#include "buzzer.h"
#include "web.h"
#include "webseite.h"
#include "webseite_gz.h"   // gepackte Weboberflaeche (erzeugt von scripts/webseite_gz.py)
#include "wlan_zugang.h"
#include "akku.h"
#include "antrieb.h"
#include "lichter.h"
#include "ledring.h"
#include "figuren.h"
#include "aufnahme.h"
#include "balance.h"
#include "gyro.h"
#include "einstellungen.h"
#include "neustart.h"
#include "zeit.h"
#include "kamera.h"
#include "mikro.h"
#include "karte.h"
#include "lernen.h"
#include "medien.h"
#include "video.h"

static WebServer server(80);
static WiFiUDP appUdp;                        // Fahrbefehle der App im WLAN (gleiches Textformat wie Bluetooth)
static bool klatschAn = false;               // XIAO: Doppelklatschen schaltet das Licht (fuer die Anzeige)
static bool serverLaeuft = false;
static bool staVerbunden = false;           // im Heim-WLAN
static bool setupAktiv = false;             // eigenes Einrichtungs-WLAN offen
static DNSServer dns;                       // leitet im Einrichtungsmodus alle Adressen aufs Auto
static String wlanName, wlanPasswort;       // gespeicherte Zugangsdaten
static unsigned long neustartUm = 0;        // nach dem Speichern kurz warten, dann neu starten
static unsigned long letzterNeuversuch = 0; // Einrichtungsmodus: wann zuletzt das Heim-WLAN probiert

static int x = 0, y = 0;
static int tasten = 0;                        // gehaltene Tasten (Bits)
static int aktion = 0;                        // offene Einmal-Aktion
static int modus = 0;                         // nur fuer die Anzeige
static unsigned long letzterFahrbefehl = 0;   // Totmann: ohne neue Befehle -> Stopp
static unsigned long letzteAbfrage = 0;       // Seite offen?
static bool ueberAutoWlan = false;            // letzte Anfrage kam ueber das eigene WLAN des Autos (nicht den Router)
static unsigned long wlanStart = 0;
static int  ereignis = 0;                     // fuer webEreignis()
static bool fehlerGemeldet = false;

// Name des Autos fuer Bluetooth und eigenes WLAN: Anfang + die letzten 4 Stellen der Chip-Nummer,
// z. B. "Roboauto-3F2A". Jedes Auto hat so seinen eigenen Namen.
const char* autoName() {
  static char name[32] = "";
  if (!name[0]) {
    // Eigener Name aus den Einstellungen ("Roboauto-Blitz"), sonst die Chip-Nummer ("Roboauto-3F2A").
    // Einmal beim Start festgelegt - ein neuer Name gilt nach dem Neustart.
    if (einst().name[0]) {
      snprintf(name, sizeof(name), "%s-%s", AUTO_NAME_ANFANG, einst().name);
    } else {
      uint64_t mac = ESP.getEfuseMac();
      snprintf(name, sizeof(name), "%s-%02X%02X", AUTO_NAME_ANFANG, (uint8_t)(mac >> 32), (uint8_t)(mac >> 40));
    }
  }
  return name;
}
#ifndef OTA_PASSWORT
#define OTA_PASSWORT ""
#endif

// ------------------------------------------------------------
//  Updates ueber WLAN (ArduinoOTA): VS Code schickt die neue Firmware,
//  das Auto schreibt sie in den freien Programmplatz und startet neu.
// ------------------------------------------------------------
static void starteOta() {
  ArduinoOTA.setHostname(WEB_NAME);
  if (strlen(OTA_PASSWORT) > 0) ArduinoOTA.setPassword(OTA_PASSWORT);

  ArduinoOTA.onStart([]() {
    antriebStopp();                       // Sicherheit: waehrend des Updates nicht fahren
    Serial.println(">> WLAN-UPDATE startet...");
    buzzerPiepsen(1800, 80);
    ringFortschritt(0, 0x8000FF);
  });
  ArduinoOTA.onProgress([](unsigned int fertig, unsigned int gesamt) {
    static int letzte = -1;
    int prozent = gesamt ? fertig * 100 / gesamt : 0;
    if (prozent != letzte) {
      letzte = prozent;
      ringFortschritt(prozent, 0x8000FF); // violetter Balken fuellt sich
      if (prozent % 10 == 0) Serial.printf(">> Update: %d %%\n", prozent);
    }
  });
  ArduinoOTA.onEnd([]() {
    Serial.println(">> WLAN-UPDATE fertig - starte neu");
    ringFortschritt(100, 0x00FF40);       // gruen = geschafft
    buzzerPiepsen(2600, 150);
    delay(50);
  });
  ArduinoOTA.onError([](ota_error_t fehler) {
    Serial.printf(">> WLAN-UPDATE FEHLER %u (Passwort? Verbindung?)\n", fehler);
    ringFortschritt(100, 0xFF0000);       // rot = fehlgeschlagen
    buzzerPiepsen(300, 400);
  });
  ArduinoOTA.begin();
  Serial.println(">> WLAN-Updates bereit");
}

// ------------------------------------------------------------
//  Zugangsdaten im Speicher des ESP32 (bleiben auch nach Updates erhalten)
// ------------------------------------------------------------
// Das Auto merkt sich mehrere WLANs (zu Hause, bei Freunden ...). Liste: zuletzt benutztes zuerst.
constexpr int WLAN_MAX = 8;
static String netzName[WLAN_MAX], netzPass[WLAN_MAX];
static int netzAnzahl = 0;

static void speichereListe() {
  Preferences p;
  p.begin("roboauto", false);
  p.putInt("anzahl", netzAnzahl);
  for (int i = 0; i < WLAN_MAX; i++) {
    String ks = "s" + String(i), kp = "p" + String(i);
    if (i < netzAnzahl) { p.putString(ks.c_str(), netzName[i]); p.putString(kp.c_str(), netzPass[i]); }
    else if (p.isKey(ks.c_str())) { p.remove(ks.c_str()); p.remove(kp.c_str()); }
  }
  p.end();
}

static void ladeZugang() {
  Preferences p;
  p.begin("roboauto", false);
  // Einmalig: falls noch in include/wlan_zugang.h eingetragen -> in den Speicher uebernehmen
  if (!p.getBool("migriert", false)) {
    if (strlen(WLAN_NAME) > 0) {
      p.putString("ssid", WLAN_NAME);
      p.putString("pass", WLAN_PASSWORT);
    }
    p.putBool("migriert", true);
  }
  int anzahl = p.getInt("anzahl", -1);
  bool umstellen = anzahl < 0;
  if (umstellen) {                                  // alte Version: nur ein Netz unter "ssid"/"pass"
    String alt = p.getString("ssid", "");
    netzAnzahl = 0;
    if (alt.length()) { netzName[0] = alt; netzPass[0] = p.getString("pass", ""); netzAnzahl = 1; }
  } else {
    netzAnzahl = constrain(anzahl, 0, WLAN_MAX);
    for (int i = 0; i < netzAnzahl; i++) {
      netzName[i] = p.getString(("s" + String(i)).c_str(), "");
      netzPass[i] = p.getString(("p" + String(i)).c_str(), "");
    }
  }
  p.end();
  if (umstellen) speichereListe();
  Serial.printf(">> WLAN: %d Netzwerk(e) gespeichert\n", netzAnzahl);
  for (int i = 0; i < netzAnzahl; i++) Serial.printf("   %d. %s\n", i + 1, netzName[i].c_str());
}

static int netzFinde(const String& name) {
  for (int i = 0; i < netzAnzahl; i++) if (netzName[i] == name) return i;
  return -1;
}

static void netzNachVorne(int i) {
  if (i <= 0 || i >= netzAnzahl) return;
  String n = netzName[i], pw = netzPass[i];
  for (int k = i; k > 0; k--) { netzName[k] = netzName[k - 1]; netzPass[k] = netzPass[k - 1]; }
  netzName[0] = n; netzPass[0] = pw;
}

// Neues Netz merken (oder Passwort aendern) - kommt an die erste Stelle
static void merkeNetz(const String& name, const String& pass) {
  int i = netzFinde(name);
  if (i < 0) {
    if (netzAnzahl == WLAN_MAX) netzAnzahl--;      // Liste voll: das am laengsten nicht benutzte faellt raus
    i = netzAnzahl++;
    netzName[i] = name;
  }
  netzPass[i] = pass;
  netzNachVorne(i);
  speichereListe();
}

static void netzEntfernen(int i) {
  if (i < 0 || i >= netzAnzahl) return;
  for (int k = i; k < netzAnzahl - 1; k++) { netzName[k] = netzName[k + 1]; netzPass[k] = netzPass[k + 1]; }
  netzAnzahl--;
  speichereListe();
}

void webWlanVergessen() {
  netzAnzahl = 0;
  speichereListe();
  Serial.println(">> Alle WLAN-Zugangsdaten geloescht - starte im Einrichtungsmodus neu");
  neustartUm = millis() + 800;
}

// ------------------------------------------------------------
//  Verbinden: erst suchen, dann das staerkste bekannte Netz nehmen.
//  Klappt es nicht, das naechste bekannte probieren. Am Ende: Einrichtungsmodus.
// ------------------------------------------------------------
enum WlanPhase { W_AUS, W_SUCHE, W_VERBINDE };
static WlanPhase phase = W_AUS;
static int kandidat[WLAN_MAX], kandAnzahl = 0, kandPos = 0, kandAktuell = -1;

static void starteSuche() {
  WiFi.scanNetworks(true);
  phase = W_SUCHE;
}

static void sucheAuswerten() {
  int n = WiFi.scanComplete();
  int staerke[WLAN_MAX];
  kandAnzahl = 0; kandPos = 0;
  for (int j = 0; j < netzAnzahl; j++) {
    int best = -999;
    for (int i = 0; i < n; i++) if (WiFi.SSID(i) == netzName[j] && WiFi.RSSI(i) > best) best = WiFi.RSSI(i);
    if (best == -999) continue;
    int k = kandAnzahl++;                           // nach Signalstaerke einsortieren
    while (k > 0 && staerke[k - 1] < best) { kandidat[k] = kandidat[k - 1]; staerke[k] = staerke[k - 1]; k--; }
    kandidat[k] = j; staerke[k] = best;
  }
  // Nichts Bekanntes in Reichweite: das zuletzt benutzte trotzdem probieren (koennte ein verstecktes Netz sein)
  if (kandAnzahl == 0 && netzAnzahl > 0 && !setupAktiv) kandidat[kandAnzahl++] = 0;
  Serial.printf(">> WLAN-Suche: %d Netze gefunden, davon %d bekannt\n", max(n, 0), kandAnzahl);
}

// true = Versuch gestartet, false = keine Kandidaten mehr
static bool verbindeNaechsten() {
  if (kandPos >= kandAnzahl) { phase = W_AUS; kandAktuell = -1; return false; }
  kandAktuell = kandidat[kandPos++];
  wlanName = netzName[kandAktuell];
  wlanPasswort = netzPass[kandAktuell];
  WiFi.begin(wlanName.c_str(), wlanPasswort.c_str());
  wlanStart = millis();
  phase = W_VERBINDE;
  Serial.printf(">> WLAN: verbinde mit \"%s\" ...\n", wlanName.c_str());
  return true;
}

// ------------------------------------------------------------
//  Einrichtungsmodus: eigenes WLAN "Roboauto-Setup" + Einrichtungsseite
// ------------------------------------------------------------
static void starteEinrichtung() {
  WiFi.disconnect();                        // keine Verbindungsversuche mehr (stoert sonst das eigene WLAN)
  WiFi.mode(WIFI_AP_STA);                   // AP fuer das Handy, STA nur fuer die Netzwerksuche
  WiFi.softAP(SETUP_WLAN_NAME);
  dns.start(53, "*", WiFi.softAPIP());      // jede Adresse -> Auto => Seite oeffnet sich von selbst
  WiFi.scanNetworks(true);                  // Netzwerke im Hintergrund suchen
  setupAktiv = true;
  letzterNeuversuch = millis();
  ereignis = 3;
  Serial.printf(">> EINRICHTUNG: Mit dem Handy ins WLAN \"%s\" gehen, die Seite oeffnet sich\n"
                "   von selbst (sonst http://%s aufrufen)\n",
                SETUP_WLAN_NAME, WiFi.softAPIP().toString().c_str());
}

// Eigenes WLAN "Roboauto-XXXX" zum Fahren: das Handy verbindet sich direkt mit dem Auto, ohne Router.
// Laeuft neben dem Heim-WLAN (gleicher Funkkanal wie der Router). Das Auto ist dort 192.168.4.1.
static void starteFahrWlan() {
  WiFi.mode(WIFI_AP_STA);
  WiFi.softAP(autoName());
  medienServerStarten();                  // Video/Ton auch direkt im Auto-WLAN (nicht erst mit Heim-WLAN)
  Serial.printf(">> Eigenes WLAN \"%s\" offen (App direkt verbinden: %s)\n",
                autoName(), WiFi.softAPIP().toString().c_str());
}

// HTML-Sonderzeichen in Netzwerknamen entschaerfen
// Fahrtrichtung fuer den Kompass: 0..360 Grad im Uhrzeigersinn, 0 = Richtung beim Einschalten
static float kurs() {
  float k = fmodf(-gyroWinkel(), 360.0f);
  return k < 0 ? k + 360.0f : k;
}

static String html(const String& t) {
  String r;
  for (unsigned i = 0; i < t.length(); i++) {
    char c = t[i];
    if (c == '<') r += "&lt;"; else if (c == '>') r += "&gt;";
    else if (c == '&') r += "&amp;"; else if (c == '"') r += "&quot;"; else r += c;
  }
  return r;
}

// Signalstaerke als 4 kleine Balken (SVG)
static String signalSymbol(int balken) {
  String s = "<svg width='22' height='18' viewBox='0 0 22 18'>";
  for (int i = 0; i < 4; i++) {
    int h = 5 + i * 4;
    s += "<rect x='" + String(i * 6) + "' y='" + String(18 - h) + "' width='4' height='" + String(h) +
         "' rx='1.5' fill='" + (i < balken ? "#4f9cff" : "#323a45") + "'/>";
  }
  return s + "</svg>";
}

// Seite = Kopf + Inhalt + Fuss (Design und Skript stehen in webseite.h)
static void sendeSeite(const String& inhalt) {
  server.sendHeader("Cache-Control", "no-store");
  server.send(200, "text/html", String(FPSTR(EINRICHTUNG_KOPF)) + inhalt + String(FPSTR(EINRICHTUNG_FUSS)));
}

static void sendeEinrichtungsSeite() {
  String s = "<div class='karte'>";
  if (staVerbunden) {
    s += "<div class='meldung ok'>&#9989;<span><span data-en='Currently connected to'>Aktuell verbunden mit</span> <b>" +
         html(wlanName) + "</b> (" + WiFi.localIP().toString() + ")</span></div>";
  }
  s += "<div class='schritte'><span class='an' data-en='1 &middot; Network'>1 &middot; Netzwerk</span>"
       "<span data-en='2 &middot; Password'>2 &middot; Passwort</span><span data-en='3 &middot; Done'>3 &middot; Fertig</span></div>"
       "<form method='POST' action='/speichern'>"
       "<div class='zeile'><h2 data-en='Choose your Wi-Fi'>WLAN ausw&auml;hlen</h2>"
       "<a class='neu' href='/scan' data-en='&#8635; Search again'>&#8635; Neu suchen</a></div><div class='netze'>";
  int n = WiFi.scanComplete();
  if (n == WIFI_SCAN_RUNNING || n == WIFI_SCAN_FAILED) {
    s += "<div id='sucht' class='leise' data-en='Searching for networks&hellip;'>Suche nach Netzwerken&hellip;</div>"
         "<div class='lade'></div><div class='lade'></div><div class='lade'></div>";
    if (n == WIFI_SCAN_FAILED) WiFi.scanNetworks(true);
  } else {
    // doppelte Namen nur einmal (staerkstes Signal), nach Signalstaerke sortiert
    int idx[30]; int anzahl = 0;
    for (int i = 0; i < n && anzahl < 30; i++) {
      if (WiFi.SSID(i).length() == 0) continue;
      int doppelt = -1;
      for (int j = 0; j < anzahl; j++) if (WiFi.SSID(idx[j]) == WiFi.SSID(i)) doppelt = j;
      if (doppelt < 0) idx[anzahl++] = i;
      else if (WiFi.RSSI(i) > WiFi.RSSI(idx[doppelt])) idx[doppelt] = i;
    }
    for (int a = 1; a < anzahl; a++)
      for (int b = a; b > 0 && WiFi.RSSI(idx[b]) > WiFi.RSSI(idx[b - 1]); b--) { int t = idx[b]; idx[b] = idx[b - 1]; idx[b - 1] = t; }
    if (anzahl == 0) s += "<div class='leise' data-en='No networks found.'>Keine Netzwerke gefunden.</div>";
    for (int k = 0; k < anzahl && k < 20; k++) {
      int i = idx[k];
      String name = html(WiFi.SSID(i));
      bool offen = WiFi.encryptionType(i) == WIFI_AUTH_OPEN;
      bool bekannt = netzFinde(WiFi.SSID(i)) >= 0;
      int balken = constrain(map(WiFi.RSSI(i), -90, -45, 1, 4), 1, 4);
      s += "<label class='netz'><input type='radio' name='ssid' value='" + name + "' data-offen='" + (offen ? "1" : "0") + "' data-bekannt='" + (bekannt ? "1" : "0") + "'>" +
           signalSymbol(balken) + "<span class='name'>" + name + "</span>" +
           (bekannt ? "<span class='marke' data-en='saved'>gespeichert</span>" : "") +
           (offen ? "" : "<span title='gesch&uuml;tzt'>&#128274;</span>") + "<span class='haken'>&#10003;</span></label>";
    }
  }
  s += "</div><details class='hand'><summary data-en='Hidden network? Enter the name by hand'>Verstecktes Netz? Name von Hand eingeben</summary>"
       "<input class='text' id='hand' name='ssid_hand' placeholder='WLAN-Name' data-en-ph='Wi-Fi name' autocapitalize='off' autocorrect='off'></details>"
       "<label class='feld' for='pw' data-en='Password'>Passwort</label>"
       "<div class='pwfeld'><input class='text' id='pw' name='pass' type='password' placeholder='WLAN-Passwort' data-en-ph='Wi-Fi password' autocapitalize='off' autocorrect='off'>"
       "<button type='button' class='auge' id='auge' aria-label='Passwort zeigen'>&#128065;</button></div>"
       "<button class='haupt' id='los' type='submit' disabled data-en='Save &amp; connect'>Speichern &amp; verbinden</button></form></div>"
       "<p class='hinweis' data-en='The car only supports 2.4&nbsp;GHz Wi-Fi.'>Das Auto kann nur 2,4-GHz-WLAN.</p>";
  if (netzAnzahl > 0) {
    s += "<div class='karte'><div class='zeile'><h2 data-en='Saved networks'>Gespeicherte Netzwerke</h2><span class='leise'>" +
         String(netzAnzahl) + " / " + String(WLAN_MAX) + "</span></div><div class='gespeichert'>";
    for (int i = 0; i < netzAnzahl; i++) {
      bool aktiv = staVerbunden && netzName[i] == wlanName;
      s += "<div class='gsp'><span class='name'>" + html(netzName[i]) + "</span>" +
           (aktiv ? "<span class='marke gruen' data-en='connected'>verbunden</span>" : "") +
           "<a class='weg' href='/entfernen?i=" + String(i) + "' data-name='" + html(netzName[i]) + "' title='vergessen'>&#10005;</a></div>";
    }
    s += "</div><p class='hinweis' style='text-align:left;margin-top:12px' data-en='The car remembers up to 8 networks and automatically connects to the strongest known one &ndash; at home, at friends&rsquo; places, anywhere.'>"
         "Das Auto merkt sich bis zu 8 Netzwerke und verbindet sich beim Einschalten automatisch mit dem st&auml;rksten bekannten &ndash; zu Hause, bei Freunden, &uuml;berall.</p></div>";
  }
  if (staVerbunden) s += "<p class='hinweis'><a href='/' data-en='&larr; back to the controls'>&larr; zur&uuml;ck zur Steuerung</a></p>";
  sendeSeite(s);
}

// ------------------------------------------------------------
//  Steuerbefehle: kommen von der Webseite (HTTP) oder von der App (HTTP oder Bluetooth).
//  Beide Wege landen hier, damit alles gleich funktioniert. Protokoll: docs/app-protokoll.md
// ------------------------------------------------------------
struct Param { String name, wert; };
constexpr int PARAM_MAX = 24;

static bool hatParam(const Param* p, int n, const char* name) {
  for (int i = 0; i < n; i++) if (p[i].name == name) return true;
  return false;
}
static String param(const Param* p, int n, const char* name) {
  for (int i = 0; i < n; i++) if (p[i].name == name) return p[i].wert;
  return "";
}

static String statusJson() {
  char ringText[8 * 7 + 1] = "";                   // 8 Ring-LEDs als "rrggbb,rrggbb,..."
  for (int i = 0; i < LED_RING_ANZAHL && i < 8; i++)
    snprintf(ringText + strlen(ringText), sizeof(ringText) - strlen(ringText), i ? ",%06lx" : "%06lx",
             (unsigned long)ringAnzeigeFarbe(i));
  char json[1200];
  int n = snprintf(json, sizeof(json),
           "{\"akku\":%d,\"prozent\":%d,\"usb\":%d,\"eco\":%d,\"links\":%d,\"rechts\":%d,\"rssi\":%d,"
           "\"licht\":%d,\"fern\":%d,\"warn\":%d,\"wende\":%d,\"modus\":%d,\"figur\":%d,"
           "\"rec\":%d,\"play\":%d,\"reclen\":%.1f,\"playpos\":%.1f,\"balance\":%d,"
           "\"nicken\":%.1f,\"rollen\":%.1f,\"kurs\":%.1f,\"dreh\":%.0f,\"kal\":%d,\"mt\":%d,\"lied\":%d,\"liedpos\":%d,\"ton\":%d,\"fw\":%d,\"fwneu\":%d,\"upd\":%d,\"updp\":%d,"
           "\"lampen\":\"%06lx,%06lx,%06lx,%06lx\",\"ring\":\"%s\"}",
           akkuWert(), akkuProzent(), akkuUsb(), akkuEco(), antriebLinks(), antriebRechts(), WiFi.RSSI(),
           lichtIstAn(), lichtIstFernlicht(), lichtIstWarnblinker(), antriebWendeAktiv(), modus, figurNummer(),
           aufnahmeLaeuft(), abspielenLaeuft(), aufnahmeSekunden(), abspielenSekunden(), balanceAktiv(),
           -gyroNeigungY(), gyroNeigungX(), kurs(), gyroDrehrate(),   // nicken: Schnauze hoch = positiv
           gyroKalibriertGerade(), antriebTestSeite() + 1, musikNummer(), musikFortschritt(), musikTon(),
           autoUpdateBuild(), autoUpdateNeu(), autoUpdateZustand(), autoUpdateProzent(),
           (unsigned long)lichtAnzeigeFarbe(0), (unsigned long)lichtAnzeigeFarbe(1),
           (unsigned long)lichtAnzeigeFarbe(2), (unsigned long)lichtAnzeigeFarbe(3), ringText);
  // XIAO Sense: Kamera, Mikrofon, SD-Karte, Lernen (die schliessende Klammer wird ersetzt)
  snprintf(json + n - 1, sizeof(json) - n + 1,
           ",\"kam\":%d,\"aufl\":%d,\"mik\":%d,\"pegel\":%d,\"klatsch\":%d,\"sd\":%d,"
           "\"lernen\":%d,\"fahrt\":%d,\"bilder\":%d,\"lernsek\":%.0f,\"foto\":%d,\"medien\":%d,"
           "\"vid\":%d,\"vidsek\":%.0f,\"vidton\":%d,\"vidz\":%d,\"af\":%d,\"afok\":%d}",
           kameraDa(), kameraAufloesungStufe(), mikroDa(), mikroPegel(), klatschAn, karteDa(),
           lernenAktiv(), lernenFahrt(), lernenBilder(), lernenSekunden(), lernenLetztesFoto(), MEDIEN_PORT,
           videoLaeuft(), videoSekunden(), videoMitTon(), videoZaehler(), kameraFokusArt(), kameraScharf());
  return String(json);
}

// Netzwerke in der Naehe als JSON (fuer die App). Die Suche laeuft im Hintergrund - solange: {"suche":1}
static String jsonText(const String& s) {
  String r = "\"";
  for (unsigned i = 0; i < s.length(); i++) {
    char c = s[i];
    if (c == '"' || c == '\\') { r += '\\'; r += c; }
    else if ((uint8_t)c < 0x20) { char h[8]; snprintf(h, sizeof(h), "\\u%04x", c); r += h; }
    else r += c;
  }
  return r + "\"";
}
static String netzListe(int n) {
  // gleiche Namen nur einmal (das staerkste), nach Signal sortiert, hoechstens 20
  int idx[20], anzahl = 0;
  for (int i = 0; i < n; i++) {
    if (WiFi.SSID(i).length() == 0) continue;
    int doppelt = -1;
    for (int j = 0; j < anzahl; j++) if (WiFi.SSID(idx[j]) == WiFi.SSID(i)) doppelt = j;
    if (doppelt >= 0) { if (WiFi.RSSI(i) > WiFi.RSSI(idx[doppelt])) idx[doppelt] = i; continue; }
    if (anzahl < 20) idx[anzahl++] = i;
  }
  for (int a = 1; a < anzahl; a++)
    for (int b = a; b > 0 && WiFi.RSSI(idx[b]) > WiFi.RSSI(idx[b - 1]); b--) { int z = idx[b]; idx[b] = idx[b - 1]; idx[b - 1] = z; }
  const bool verbunden = WiFi.status() == WL_CONNECTED;   // v = damit ist das Auto gerade verbunden
  String r = "{\"netze\":[";
  for (int k = 0; k < anzahl; k++) {
    int i = idx[k];
    if (k) r += ',';
    r += "{\"n\":" + jsonText(WiFi.SSID(i)) + ",\"s\":" + String(WiFi.RSSI(i)) +
         ",\"z\":" + (WiFi.encryptionType(i) == WIFI_AUTH_OPEN ? "0" : "1") +
         ",\"g\":" + (netzFinde(WiFi.SSID(i)) >= 0 ? "1" : "0") +
         ",\"v\":" + (verbunden && WiFi.SSID(i) == WiFi.SSID() ? "1" : "0") + "}";
  }
  return r + "]}";
}
static String netzeJson(bool neu) {
  if (WiFi.getMode() == WIFI_OFF) WiFi.mode(WIFI_STA);
  // Ergebnis merken: im Einrichtungsmodus sucht das Auto auch selbst und wuerde es sonst ueberschreiben
  static String liste;
  static unsigned long gestartet = 0;
  static bool frisch = false;                 // Ergebnis stammt aus einer Suche nach dem letzten Start
  int n = WiFi.scanComplete();
  if (n >= 0) { liste = netzListe(n); frisch = true; }
  if (n == WIFI_SCAN_RUNNING && !neu) return "{\"suche\":1}";
  if (neu || (!frisch && n < 0 && millis() - gestartet > 3000)) {
    if (n != WIFI_SCAN_RUNNING) {
      WiFi.scanDelete();
      WiFi.scanNetworks(true);
    }
    gestartet = millis(); frisch = false;
    return "{\"suche\":1}";
  }
  return frisch ? liste : String("{\"suche\":1}");
}

// app = true: kam ueber Bluetooth (zaehlt nicht als "Webseite offen")
static String steuerBefehl(const String& pfad, const Param* p, int n, bool app) {
  if (pfad == "/fahr") {
    x = constrain(param(p, n, "x").toInt(), -JOYSTICK_MAX, JOYSTICK_MAX);
    y = constrain(param(p, n, "y").toInt(), -JOYSTICK_MAX, JOYSTICK_MAX);
    tasten = param(p, n, "t").toInt();
    letzterFahrbefehl = millis();
    if (!app) letzteAbfrage = millis();
    return "ok";
  }
  if (pfad == "/aktion") {
    aktion = param(p, n, "a").toInt();
    if (!app) letzteAbfrage = millis();
    return "ok";
  }
  if (pfad == "/status") {
    if (!app) letzteAbfrage = millis();
    return statusJson();
  }
  // Kamera-Aufloesung: /kamera?aufl=0..2
  // Video-Aufnahme: /video?an=1&ton=1 (Ton nur, wenn er auf der Seite eingeschaltet ist), /video?an=0
  if (pfad == "/video") {
    if (param(p, n, "an") == "1") { if (videoAufnahmeStarten(param(p, n, "ton") == "1")) buzzerEin(); else buzzerWarnung(); }
    else if (param(p, n, "an") == "0") { videoAufnahmeStoppen(); buzzerAus(); }
    return "ok";
  }
  if (pfad == "/kamera") {
    if (hatParam(p, n, "aufl")) kameraAufloesung(param(p, n, "aufl").toInt());
    if (hatParam(p, n, "quali")) kameraQualitaet(param(p, n, "quali").toInt());
    if (hatParam(p, n, "fokus")) kameraFokus(param(p, n, "fokus") == "1");   // 1 = einmal scharf + fest, 0 = automatisch
    return "ok";
  }
  // SD-Karte: Ueberblick (Dateiliste und Downloads laufen ueber den Medien-Server)
  // /karte?formatieren=JA  = Karte als FAT32 neu anlegen (loescht alles, laeuft im Hintergrund)
  if (pfad == "/karte") {
    if (param(p, n, "formatieren") == "JA") {
      antriebStopp();
      Serial.println(karteFormatieren() ? ">> SD-Karte: Formatieren gestartet" : ">> SD-Karte: Formatieren geht gerade nicht");
    }
    return karteJson();
  }
  // Einstellungen lesen: /einstellungen   aendern: /einstellungen?tempo=150&toene=1 ...
  if (pfad == "/einstellungen") {
    if (hatParam(p, n, "standard")) {
      einstellungenStandard();
    } else if (hatParam(p, n, "motorStandard")) {
      einstellungenMotorStandard();
    } else if (n > 0) {
      String nameVorher = einst().name;
      for (int i = 0; i < n; i++) einstellungSetzen(p[i].name, p[i].wert);
      einstellungenSpeichern();
      if (hatParam(p, n, "lautstaerke")) buzzerProbe();   // neue Lautstaerke gleich hoerbar
      Serial.println(">> Einstellungen gespeichert: " + einstellungenJson());
      // Neuer Name: Bluetooth und WLAN bekommen ihn erst beim Start -> kurz danach neu starten
      if (nameVorher != einst().name) {
        Serial.printf(">> Neuer Name \"%s\" - starte neu\n", einst().name);
        neustartUm = millis() + 1500;
      }
    }
    return einstellungenJson();
  }
  // Auto-Update: /update?a=suchen  oder  /update?a=installieren
  if (pfad == "/update") {
    String a = param(p, n, "a");
    if (a == "suchen") autoUpdateSuchen();
    if (a == "installieren") { autoUpdateSuchen(); autoUpdateInstallieren(); }
    if (!app) letzteAbfrage = millis();
    return "ok";
  }
  if (pfad == "/verlauf") return akkuVerlaufJson();
  // Fehlersuche: welche Geraete antworten am I2C-Bus (D4/D5)? 0x68 = Gyro, 0x36 = Akkuwaechter
  // /i2c?tausch=1 sucht mit vertauschten Leitungen (SDA an D5, SCL an D4)
  if (pfad == "/i2c") {
    bool tausch = param(p, n, "tausch") == "1";
    int sda = tausch ? GYRO_SCL_PIN : GYRO_SDA_PIN, scl = tausch ? GYRO_SDA_PIN : GYRO_SCL_PIN;
    Wire.end();
    Wire.begin(sda, scl);
    String r = "{\"sda\":" + String(digitalRead(sda)) + ",\"scl\":" + String(digitalRead(scl)) + ",\"geraete\":[";
    bool erstes = true;
    for (uint8_t a = 1; a < 127; a++) {
      Wire.beginTransmission(a);
      if (Wire.endTransmission() == 0) { r += (erstes ? "\"0x" : ",\"0x") + String(a, HEX) + "\""; erstes = false; }
    }
    if (tausch) { Wire.end(); Wire.begin(GYRO_SDA_PIN, GYRO_SCL_PIN); }   // wieder normal
    return r + "]}";
  }
  // Fehlersuche: einen I2C-Pin ohne I2C pruefen - /pintest?nr=6
  // liest ihn mit internem Pull-up, mit Pull-down und als Ausgang auf High
  if (pfad == "/pintest") {
    int nr = param(p, n, "nr").toInt();
    if (nr != GYRO_SDA_PIN && nr != GYRO_SCL_PIN) return "nur die I2C-Pins";
    Wire.end();
    pinMode(nr, INPUT_PULLUP);   delay(5); int hoch = digitalRead(nr);
    pinMode(nr, INPUT_PULLDOWN); delay(5); int runter = digitalRead(nr);
    pinMode(nr, OUTPUT); digitalWrite(nr, HIGH); delay(5); int ausgang = digitalRead(nr);
    pinMode(nr, INPUT);
    Wire.begin(GYRO_SDA_PIN, GYRO_SCL_PIN);
    return "{\"pin\":" + String(nr) + ",\"pullup\":" + hoch + ",\"pulldown\":" + runter + ",\"ausgangHigh\":" + ausgang + "}";
  }
  // WLAN einrichten aus der App ueber Bluetooth (das Auto braucht dafuer noch kein WLAN).
  // Nur ueber Bluetooth: das Passwort soll nicht als Adresse durchs Heimnetz gehen.
  //   /netze[?neu=1]            -> {"suche":1} oder {"netze":[{"n":"Name","s":-60,"z":1,"g":1,"v":1},...]}
  //                                (s = Signal in dBm, z = mit Passwort, g = schon gespeichert, v = gerade verbunden)
  //   /wlanspeichern?n=Name&p=Passwort  -> "ok" (startet neu und verbindet sich), leeres Passwort = gespeichertes behalten
  if (app && pfad == "/netze") return netzeJson(param(p, n, "neu") == "1");
  if (app && pfad == "/wlanspeichern") {
    String name = param(p, n, "n"), pass = param(p, n, "p");
    if (name.length() == 0 || name.length() > 32 || pass.length() > 64) return "fehler";
    int bekannt = netzFinde(name);
    if (pass.length() == 0 && bekannt >= 0) pass = netzPass[bekannt];
    merkeNetz(name, pass);
    Serial.printf(">> Neue WLAN-Daten aus der App: \"%s\" - starte neu\n", name.c_str());
    neustartUm = millis() + 1500;
    return "ok";
  }
  // Fuer die App: ueber welche Adresse ist das Auto im WLAN erreichbar?
  // Uhrzeit vom Browser/App: /zeit?t=Sekunden seit 1970 (UTC) - fuer Datum/Uhrzeit in Dateinamen
  if (pfad == "/zeit") { zeitSetzen(strtoul(param(p, n, "t").c_str(), nullptr, 10)); return "ok"; }
  if (pfad == "/info") {
    if (param(p, n, "abstuerzeLoeschen") == "1") neustartZaehlerLoeschen();
    bool da = webWlanDa();
    return String("{\"name\":\"") + WEB_NAME + "\",\"ble\":\"" + autoName() + "\",\"wlan\":" + (da ? 1 : 0) +
           ",\"ip\":\"" + (da ? WiFi.localIP().toString() : String("")) + "\",\"fw\":" + autoUpdateBuild() +
           ",\"udp\":" + APP_UDP_PORT + ",\"board\":\"" + BOARD_NAME + "\"" +   // board: welche Oberflaeche die App zeigt
           // Neustart-Grund, Laufzeit in s und gezaehlte Abstuerze (Webseite: Einstellungen > System)
           ",\"rst\":" + neustartGrund() + ",\"lauf\":" + (millis() / 1000) +
           ",\"abst\":" + neustartAbstuerze() + ",\"abstGrund\":" + neustartLetzterAbsturz() + "}";
  }
  return "?";
}

static void httpSteuerung() {
  Param p[PARAM_MAX];
  int n = min(server.args(), PARAM_MAX);
  for (int i = 0; i < n; i++) p[i] = {server.argName(i), server.arg(i)};
  ueberAutoWlan = server.client().localIP() == WiFi.softAPIP();   // fuer die Farbe des LED-Rings
  String antwort = steuerBefehl(server.uri(), p, n, false);
  server.send(200, antwort.startsWith("{") ? "application/json" : "text/plain", antwort);
}

// %41 -> 'A', '+' -> ' '
static String urlDekodieren(const String& s) {
  String r;
  for (unsigned i = 0; i < s.length(); i++) {
    char c = s[i];
    if (c == '+') r += ' ';
    else if (c == '%' && i + 2 < s.length()) { r += (char)strtol(s.substring(i + 1, i + 3).c_str(), nullptr, 16); i += 2; }
    else r += c;
  }
  return r;
}

String webAppBefehl(const String& anfrage) {
  int frage = anfrage.indexOf('?');
  String pfad = frage < 0 ? anfrage : anfrage.substring(0, frage);
  Param p[PARAM_MAX];
  int n = 0;
  if (frage >= 0) {
    String rest = anfrage.substring(frage + 1);
    while (rest.length() > 0 && n < PARAM_MAX) {
      int und = rest.indexOf('&');
      String teil = und < 0 ? rest : rest.substring(0, und);
      rest = und < 0 ? String("") : rest.substring(und + 1);
      if (teil.length() == 0) continue;
      int gleich = teil.indexOf('=');
      p[n++] = {urlDekodieren(gleich < 0 ? teil : teil.substring(0, gleich)),
                gleich < 0 ? String("") : urlDekodieren(teil.substring(gleich + 1))};
    }
  }
  return steuerBefehl(pfad, p, n, true);
}

void webFahrStopp() { x = 0; y = 0; tasten = 0; letzterFahrbefehl = 0; }

void webStarten() {
  ladeZugang();
  WiFi.setHostname(WEB_NAME);

  // --- Seiten ---
  server.on("/", HTTP_GET, []() {
    if (setupAktiv) sendeEinrichtungsSeite();
    else {
      // Browser soll die Seite nicht zwischenspeichern - sonst laeuft nach einem Update noch die alte
      server.sendHeader("Cache-Control", "no-store, no-cache, must-revalidate");
      // gzip-gepackt: der Browser entpackt selbst, spart ca. 70 KB Flash
      server.sendHeader("Content-Encoding", "gzip");
      server.send_P(200, "text/html", (const char*)WEBSEITE_GZ, WEBSEITE_GZ_LAENGE);
    }
  });
  server.on("/wlan", HTTP_GET, sendeEinrichtungsSeite);
  server.on("/scan", HTTP_GET, []() {
    WiFi.scanNetworks(true);
    server.sendHeader("Location", "/wlan");
    server.send(302, "text/plain", "");
  });
  server.on("/speichern", HTTP_POST, []() {
    String name = server.arg("ssid_hand");
    if (name.length() == 0) name = server.arg("ssid");
    String pass = server.arg("pass");
    if (name.length() == 0) {
      sendeSeite("<div class='karte erfolg'><div class='kreis rot'><span style='font-size:40px'>&#10005;</span></div>"
                 "<h2 data-en='Please choose a Wi-Fi'>Bitte ein WLAN ausw&auml;hlen</h2>"
                 "<a class='neu' href='/wlan' data-en='&larr; back'>&larr; zur&uuml;ck</a></div>");
      return;
    }
    int bekannt = netzFinde(name);
    if (pass.length() == 0 && bekannt >= 0) pass = netzPass[bekannt];   // leer gelassen = gespeichertes Passwort behalten
    merkeNetz(name, pass);
    Serial.printf(">> Neue WLAN-Daten gespeichert: \"%s\" - starte neu\n", name.c_str());
    sendeSeite("<div class='karte erfolg'>"
               "<div class='schritte' style='width:100%'><span class='fertig' data-en='1 &middot; Network'>1 &middot; Netzwerk</span>"
               "<span class='fertig' data-en='2 &middot; Password'>2 &middot; Passwort</span><span class='fertig' data-en='3 &middot; Done'>3 &middot; Fertig</span></div>"
               "<div class='kreis'><span style='font-size:42px;color:#3ccf6e'>&#10003;</span></div>"
               "<h2 data-en='Saved!'>Gespeichert!</h2>"
               "<div class='leise'><span data-en='The car restarts and connects to'>Das Auto startet neu und verbindet sich mit</span> <b style='color:#eef1f5'>" + html(name) + "</b>.</div>"
               "<ol class='liste'><li data-en='Switch your phone/PC back to your normal Wi-Fi'>Handy/PC wieder ins normale WLAN wechseln</li>"
               "<li data-en='Open this address:'>Diese Adresse &ouml;ffnen:</li></ol>"
               "<div class='adresse'>http://" + String(WEB_NAME) + ".local</div>"
               "<p class='hinweis'><span data-en='If it does not work, the car opens the Wi-Fi'>Klappt es nicht, &ouml;ffnet das Auto nach 15&nbsp;s wieder das WLAN</span> &bdquo;" + String(SETUP_WLAN_NAME) + "&ldquo;.</p></div>");
    neustartUm = millis() + 1500;
  });
  server.on("/entfernen", HTTP_GET, []() {
    int i = server.arg("i").toInt();
    if (i >= 0 && i < netzAnzahl) Serial.printf(">> WLAN \"%s\" vergessen\n", netzName[i].c_str());
    netzEntfernen(i);
    server.sendHeader("Location", "/wlan");
    server.send(302, "text/plain", "");
  });
  server.on("/vergessen", HTTP_GET, []() {
    sendeSeite("<div class='karte erfolg'><div class='kreis'><span style='font-size:38px'>&#128465;</span></div>"
               "<h2 data-en='All saved Wi-Fi networks deleted'>Alle gespeicherten WLANs gel&ouml;scht</h2>"
               "<div class='leise'><span data-en='The car restarts and opens the Wi-Fi'>Das Auto startet neu und &ouml;ffnet das WLAN</span> &bdquo;" + String(SETUP_WLAN_NAME) + "&ldquo;.</div></div>");
    webWlanVergessen();
  });

  // --- Steuerung (gleiche Befehle kommen von der App auch ueber Bluetooth) ---
  for (const char* pfad : {"/fahr", "/aktion", "/status", "/kamera", "/karte", "/video", "/zeit", "/einstellungen", "/update", "/verlauf", "/info", "/i2c", "/pintest"})
    server.on(pfad, HTTP_GET, httpSteuerung);

  // Alles andere: im Einrichtungsmodus auf die Einrichtungsseite umleiten.
  // Das loest auf Handys automatisch das "Im Netzwerk anmelden"-Fenster aus.
  server.onNotFound([]() {
    if (setupAktiv) {
      server.sendHeader("Location", String("http://") + WiFi.softAPIP().toString() + "/");
      server.send(302, "text/plain", "");
    } else {
      server.send(404, "text/plain", "Nicht gefunden");
    }
  });
  // WICHTIG: Erst das WLAN einschalten, DANN den Webserver starten.
  // Andersherum stuerzt der ESP32 beim Start ab (Netzwerk-Stack noch nicht bereit).
  if (netzAnzahl == 0) {
    Serial.println(">> WLAN: noch keine Zugangsdaten gespeichert");
    starteEinrichtung();
  } else {
    starteFahrWlan();
    starteSuche();                                 // im Hintergrund suchen, dann bekanntes Netz waehlen
  }
  server.begin();
  appUdp.begin(APP_UDP_PORT);
}

// Ein UDP-Paket = eine Anfrage "<nr>|<pfad>?<params>" wie ueber Bluetooth.
// Kein Verbindungsaufbau wie bei HTTP -> der Befehl ist sofort beim Auto. nr 0 = keine Antwort.
static void appUdpUpdate() {
  while (int laenge = appUdp.parsePacket()) {
    char text[256];
    int n = appUdp.read(text, min(laenge, (int)sizeof(text) - 1));
    if (n <= 0) continue;
    text[n] = 0;
    char* strich = strchr(text, '|');
    if (!strich) continue;
    long nr = atol(text);
    String antwort = webAppBefehl(String(strich + 1));
    if (nr == 0) continue;
    appUdp.beginPacket(appUdp.remoteIP(), appUdp.remotePort());
    appUdp.printf("%ld|", nr);
    appUdp.print(antwort);
    appUdp.endPacket();
  }
}

// Kein bekanntes WLAN erreichbar -> Fehler melden und Einrichtungsmodus oeffnen
static void wlanFehlschlag() {
  if (fehlerGemeldet) return;
  fehlerGemeldet = true;
  Serial.println(">> WLAN: kein bekanntes Netz erreichbar (Passwort pruefen, nur 2,4 GHz!) - Einrichtungsmodus");
  starteEinrichtung();
  ereignis = 2;                           // Fehler hat Vorrang vor "Einrichtung offen"
}

void webUpdate() {
  appUdpUpdate();
  server.handleClient();
  if (setupAktiv) dns.processNextRequest();

  // Fehlersuche ueber das USB-Kabel: eine Zeile wie "/netze" wird ausgefuehrt wie ein Befehl der App
  static String usbZeile;
  while (Serial.available()) {
    char c = Serial.read();
    if (c == '\n' || c == '\r') {
      if (usbZeile.startsWith("/")) Serial.println(">> USB " + usbZeile + " -> " + webAppBefehl(usbZeile));
      usbZeile = "";
    } else if (usbZeile.length() < 250) usbZeile += c;
  }

  if (neustartUm != 0 && (long)(millis() - neustartUm) >= 0) {
    antriebStopp();
    ESP.restart();
  }

  // Einrichtungsmodus, aber es gibt gespeicherte Daten: regelmaessig erneut das Heim-WLAN probieren.
  // Nur wenn gerade kein Handy mit "Roboauto-Setup" verbunden ist (der Versuch stoert das eigene WLAN kurz).
  // Klappt es, wird das Einrichtungs-WLAN geschlossen und alles laeuft normal weiter.
  // --- Verbindungsablauf: Suche auswerten / naechstes bekanntes Netz probieren ---
  if (phase == W_SUCHE && WiFi.scanComplete() != WIFI_SCAN_RUNNING) {
    sucheAuswerten();
    if (!verbindeNaechsten() && !setupAktiv) wlanFehlschlag();
  }
  if (phase == W_VERBINDE) {
    if (WiFi.status() == WL_CONNECTED) {
      phase = W_AUS;
      if (kandAktuell > 0) { netzNachVorne(kandAktuell); speichereListe(); }   // zuletzt benutzt -> nach vorne
      kandAktuell = 0;
    } else if (millis() - wlanStart > WLAN_TIMEOUT_MS) {
      Serial.printf(">> WLAN: \"%s\" klappt nicht\n", wlanName.c_str());
      WiFi.disconnect();
      if (!verbindeNaechsten() && !setupAktiv) wlanFehlschlag();
    }
  }

  if (setupAktiv && netzAnzahl > 0) {
    if (WiFi.status() == WL_CONNECTED) {
      dns.stop();
      starteFahrWlan();                     // Einrichtungs-WLAN wird wieder zum Fahr-WLAN
      setupAktiv = false;
      Serial.println(">> Heim-WLAN doch erreichbar - Einrichtungsmodus beendet");
    } else if (phase == W_AUS && millis() - letzterNeuversuch > WLAN_NEUVERSUCH_MS && WiFi.softAPgetStationNum() == 0) {
      letzterNeuversuch = millis();
      Serial.println(">> Einrichtungsmodus: suche erneut nach bekannten WLANs ...");
      starteSuche();
    }
  }

  // Erstmals im Heim-WLAN -> Name im Netz, Updates ueber WLAN, Meldung
  if (!setupAktiv && !staVerbunden && WiFi.status() == WL_CONNECTED) {
    staVerbunden = true;
    MDNS.begin(WEB_NAME);
    MDNS.addService("http", "tcp", 80);
    starteOta();
    zeitInternet();                         // Uhrzeit aus dem Internet holen
    medienServerStarten();                  // Live-Video, Live-Ton, SD-Dateien auf Port 81
    serverLaeuft = true;
    ereignis = 1;                           // -> Ring + Piepen in main.cpp
    Serial.printf(">> WLAN verbunden! Im Browser oeffnen: http://%s  oder  http://%s.local\n",
                  WiFi.localIP().toString().c_str(), WEB_NAME);
  }
  if (staVerbunden) ArduinoOTA.handle();


  // Totmann-Schalter: kommt laenger kein Fahrbefehl, gilt der Stick als losgelassen
  if (millis() - letzterFahrbefehl > WEB_TOTMANN_MS) { x = 0; y = 0; tasten = 0; }
}

bool webEinrichtung() { return setupAktiv; }
bool webWlanDa()      { return staVerbunden && !setupAktiv && WiFi.status() == WL_CONNECTED; }

bool webVerbunden() { return (serverLaeuft || setupAktiv) && letzteAbfrage != 0 && millis() - letzteAbfrage < WEB_GETRENNT_MS; }
bool webUeberAutoWlan() { return ueberAutoWlan; }
int  webEreignis()  { int e = ereignis; ereignis = 0; return e; }
// Fahrbefehle kommen von der Webseite oder der App (auch ohne WLAN ueber Bluetooth) - der Totmann regelt beides
bool webFaehrt()    { return millis() - letzterFahrbefehl < WEB_TOTMANN_MS && (x != 0 || y != 0); }
void webSetzeModus(int m) { modus = m; }
void webSetzeKlatschen(bool an) { klatschAn = an; }
int  webTasten()     { return tasten; }
int  webAktion()     { int a = aktion; aktion = 0; return a; }
int  webX()         { return x; }
int  webY()         { return y; }
