ProD-byte/Roboauto/Codes/roboauto_pio/src/karte.cpp

#include <Arduino.h>
#include <SPI.h>
#include <SD.h>
#include <esp_http_server.h>
#include <esp_heap_caps.h>
#include <sd_diskio.h>
#include <esp_task_wdt.h>
#include "ff.h"
#include "diskio.h"
#include "config.h"
#include "karte.h"
#include "lernen.h"
#include "medien.h"

// ============================================================
//  microSD-Karte auf dem Sense-Board (SPI an D8/D9/D10, CS = GPIO21).
//  Hier landen Lern-Daten, Fotos und lange Fahrweg-Aufnahmen.
//  Das Dateisystem (FAT) ist von sich aus fuer mehrere Aufgaben gleichzeitig gesichert.
//  Wichtig: der ESP32 kann nur FAT/FAT32, KEIN exFAT. Grosse Karten (64 GB+) kommen ab Werk
//  mit exFAT -> dann ist die Karte "unlesbar" und kann auf der Webseite formatiert werden.
// ============================================================

constexpr uint32_t SD_TAKT = 20000000;
static bool da = false;
static bool unlesbar = false;                    // Karte antwortet, aber kein FAT-Dateisystem
static volatile int fmtZustand = KARTE_FMT_RUHE;

// Steckt eine Karte, die sich nur nicht einhaengen laesst (exFAT, NTFS, leer)?
static bool karteAntwortet() {
  uint8_t pd = sdcard_init(SD_CS_PIN, &SPI, SD_TAKT);
  if (pd == 0xFF) return false;
  bool ok = !(disk_initialize(pd) & STA_NOINIT) && sdcard_type(pd) != CARD_NONE;
  sdcard_uninit(pd);
  return ok;
}

bool karteStarten() {
  SPI.begin(SD_SCK_PIN, SD_MISO_PIN, SD_MOSI_PIN, SD_CS_PIN);
  da = SD.begin(SD_CS_PIN, SPI, SD_TAKT);
  unlesbar = false;
  if (!da || SD.cardType() == CARD_NONE) {
    if (da) SD.end();
    da = false;
    unlesbar = karteAntwortet();
    Serial.println(unlesbar ? ">> SD-Karte: gefunden, aber nicht FAT32 (exFAT?) - auf der Webseite formatieren"
                            : ">> SD-Karte: keine gefunden - Lernen und Fotos aus");
    return false;
  }
  SD.mkdir("/lernen");
  SD.mkdir("/fotos");
  SD.mkdir("/videos");
  Serial.printf(">> SD-Karte: %u MB, davon %u MB belegt\n", (unsigned)karteGesamtMB(), (unsigned)karteBelegtMB());
  return true;
}

bool karteDa()             { return da; }
bool karteUnlesbar()       { return unlesbar; }
int  karteFormatZustand()  { return fmtZustand; }

// ---------- Formatieren (FAT32) - dauert bei 128 GB bis zu einer Minute, deshalb eigene Aufgabe ----------
static void formatAufgabe(void*) {
  Serial.println(">> SD-Karte: formatiere als FAT32 ...");
  if (da) SD.end();
  da = false;
  FRESULT r = FR_NOT_READY;
  uint8_t pd = sdcard_init(SD_CS_PIN, &SPI, SD_TAKT);
  if (pd != 0xFF) {
    char drv[3] = { (char)('0' + pd), ':', 0 };
    const UINT N = 32 * 1024;                     // grosser Arbeitspuffer = schneller
    BYTE* puffer = (BYTE*)malloc(N);
    if (puffer) {
      // f_mkfs schreibt ohne Pause durch -> die Leerlauf-Aufgabe von Kern 0 kommt nicht dran und der
      // Watchdog wuerde nach 5 s neu starten. Waehrenddessen bekommt er deshalb 2 Minuten Geduld.
      esp_task_wdt_config_t lang = { 120000, 1 << 0, true }, normal = { CONFIG_ESP_TASK_WDT_TIMEOUT_S * 1000, 1 << 0, true };
      esp_task_wdt_reconfigure(&lang);
      MKFS_PARM opt = { FM_FAT32, 0, 0, 0, 32768 };                    // FAT32, 32-KB-Cluster
      r = f_mkfs(drv, &opt, puffer, N);
      if (r == FR_MKFS_ABORTED) { opt = { FM_ANY, 0, 0, 0, 0 }; r = f_mkfs(drv, &opt, puffer, N); }   // kleine Karte
      esp_task_wdt_reconfigure(&normal);
      free(puffer);
    } else r = FR_NOT_ENOUGH_CORE;
    sdcard_uninit(pd);
  }
  bool ok = r == FR_OK && karteStarten();
  Serial.printf(">> SD-Karte: Formatieren %s (FatFs %d)\n", ok ? "fertig" : "FEHLGESCHLAGEN", (int)r);
  if (ok) lernenStarten();                        // gab es beim Einschalten keine lesbare Karte, fehlt die Aufgabe noch
  fmtZustand = ok ? KARTE_FMT_FERTIG : KARTE_FMT_FEHLER;
  vTaskDelete(nullptr);
}

bool karteFormatieren() {
  if (fmtZustand == KARTE_FMT_LAEUFT || lernenAktiv()) return false;   // nicht waehrend Lernen schreibt
  if (!da && !unlesbar && !karteAntwortet()) return false;            // es steckt gar keine Karte
  fmtZustand = KARTE_FMT_LAEUFT;
  // Prioritaet 1 (nicht 0): sonst verdraengen Kamera und WLAN das Schreiben so lange,
  // dass der SD-Treiber in seine Zeitgrenzen laeuft und "Schreibfehler" meldet
  if (xTaskCreatePinnedToCore(formatAufgabe, "formatieren", 6144, nullptr, 1, nullptr, 0) != pdPASS) {
    fmtZustand = KARTE_FMT_FEHLER;
    return false;
  }
  return true;
}
uint32_t karteGesamtMB()   { return da ? (uint32_t)(SD.totalBytes() / (1024 * 1024)) : 0; }
uint32_t karteBelegtMB()   { return da ? (uint32_t)(SD.usedBytes()  / (1024 * 1024)) : 0; }

// Hoechste vorhandene Nummer suchen (z.B. fahrt_0007) und eins dazu
int karteNaechsteNummer(const char* ordner, const char* name) {
  if (!da) return 1;
  int hoechste = 0;
  size_t laenge = strlen(name);
  File d = SD.open(ordner);
  if (!d) return 1;
  for (File f = d.openNextFile(); f; f = d.openNextFile()) {
    const char* n = f.name();
    if (strncmp(n, name, laenge) == 0 && n[laenge] == '_') hoechste = max(hoechste, atoi(n + laenge + 1));
    f.close();
  }
  d.close();
  return hoechste + 1;
}

// Dateien in den Tagesordnern zaehlen (/fotos/2026-11-03/...) - lose Dateien direkt im Ordner zaehlen mit
static int zaehleTief(const char* ordner) {
  int n = 0;
  File d = SD.open(ordner);
  if (!d) return 0;
  for (File f = d.openNextFile(); f; f = d.openNextFile()) {
    if (!f.isDirectory()) { n++; continue; }
    for (File g = f.openNextFile(); g; g = f.openNextFile()) if (!g.isDirectory()) n++;
  }
  return n;
}

static int zaehle(const char* ordner) {
  int n = 0;
  File d = SD.open(ordner);
  if (!d) return 0;
  for (File f = d.openNextFile(); f; f = d.openNextFile()) { n++; f.close(); }
  d.close();
  return n;
}

String karteJson() {
  String z = ",\"unlesbar\":" + String(unlesbar ? 1 : 0) + ",\"fmt\":" + String(fmtZustand) + "}";
  if (!da || fmtZustand == KARTE_FMT_LAEUFT) return "{\"da\":0" + z;
  return "{\"da\":1,\"gesamt\":" + String(karteGesamtMB()) + ",\"belegt\":" + String(karteBelegtMB()) +
         ",\"fahrten\":" + String(zaehle("/lernen")) + ",\"fotos\":" + String(zaehleTief("/fotos")) + ",\"videos\":" + String(zaehleTief("/videos")) + z;
}

// ---------- Seiten fuer den Medien-Server ----------

// "pfad" aus der Adresse holen (mit %xx-Entschluesselung), ".." ist verboten
// Einen Wert aus der Adresse holen und %xx entschluesseln. false = nicht vorhanden
static bool holeWert(const char* anfrage, const char* name, char* ziel, size_t groesse) {
  char roh[200];
  if (httpd_query_key_value(anfrage, name, roh, sizeof(roh)) != ESP_OK) return false;
  size_t j = 0;
  for (size_t i = 0; roh[i] && j < groesse - 1; i++) {
    if (roh[i] == '%' && isxdigit(roh[i + 1]) && isxdigit(roh[i + 2])) {
      char hex[3] = { roh[i + 1], roh[i + 2], 0 };
      ziel[j++] = (char)strtol(hex, nullptr, 16);
      i += 2;
    } else ziel[j++] = roh[i] == '+' ? ' ' : roh[i];
  }
  ziel[j] = 0;
  return true;
}

// "pfad" aus der Adresse holen, ".." ist verboten. Optional: &weg=1 (loeschen), &neu=Name (umbenennen)
static bool holePfad(httpd_req_t* req, char* pfad, size_t groesse, bool* loeschen = nullptr, char* neu = nullptr, size_t neuGroesse = 0) {
  char anfrage[300];
  if (neu) neu[0] = 0;
  if (httpd_req_get_url_query_str(req, anfrage, sizeof(anfrage)) != ESP_OK) { strcpy(pfad, "/"); }
  else {
    if (!holeWert(anfrage, "pfad", pfad, groesse)) strcpy(pfad, "/");
    if (loeschen) { char w[4]; *loeschen = httpd_query_key_value(anfrage, "weg", w, sizeof(w)) == ESP_OK; }
    if (neu) holeWert(anfrage, "neu", neu, neuGroesse);
  }
  return pfad[0] == '/' && strstr(pfad, "..") == nullptr;
}

// Neuen Namen pruefen: nur Buchstaben, Ziffern, Leerzeichen, - _ . (kein Ordnerwechsel).
// Fehlt die Endung (.jpg, .avi ...), wird die alte angehaengt - sonst laesst sich die Datei nicht mehr oeffnen.
static bool neuerName(const char* altPfad, const char* wunsch, char* neuPfad, size_t groesse) {
  char name[64]; size_t j = 0;
  for (size_t i = 0; wunsch[i] && j < sizeof(name) - 1; i++) {
    char c = wunsch[i];
    if (isalnum((unsigned char)c) || c == '-' || c == '_' || c == '.' || (c == ' ' && j > 0)) name[j++] = c;
  }
  while (j > 0 && (name[j - 1] == ' ' || name[j - 1] == '.')) j--;
  name[j] = 0;
  if (!j) return false;
  const char* altName = strrchr(altPfad, '/') + 1;
  const char* altEndung = strrchr(altName, '.');
  const char* neuEndung = strrchr(name, '.');
  size_t ordner = altName - altPfad;                         // inklusive des letzten '/'
  if (ordner + j + 8 >= groesse) return false;
  memcpy(neuPfad, altPfad, ordner);
  snprintf(neuPfad + ordner, groesse - ordner, "%s%s", name,
           altEndung && (!neuEndung || strcasecmp(neuEndung, altEndung)) ? altEndung : "");
  return true;
}

// /dateien?pfad=/lernen  ->  [{"n":"fahrt_0001","g":0,"o":1}, ...]   (o = Ordner)
esp_err_t karteListeSenden(httpd_req_t* req) {
  char pfad[160];
  if (!da) { httpd_resp_send_err(req, HTTPD_404_NOT_FOUND, "keine SD-Karte"); return ESP_FAIL; }
  if (!holePfad(req, pfad, sizeof(pfad))) { httpd_resp_send_err(req, HTTPD_400_BAD_REQUEST, "pfad?"); return ESP_FAIL; }
  File d = SD.open(pfad);
  if (!d || !d.isDirectory()) { httpd_resp_send_err(req, HTTPD_404_NOT_FOUND, "kein Ordner"); return ESP_FAIL; }
  httpd_resp_set_type(req, "application/json");
  httpd_resp_send_chunk(req, "[", 1);
  bool erster = true;
  char zeile[200];
  for (File f = d.openNextFile(); f; f = d.openNextFile()) {
    // t = zuletzt geaendert (Unix-Zeit) - zum Sortieren; stimmt, sobald das Auto die Uhrzeit kennt
    int n = snprintf(zeile, sizeof(zeile), "%s{\"n\":\"%s\",\"g\":%u,\"o\":%d,\"t\":%ld}", erster ? "" : ",",
                     f.name(), (unsigned)f.size(), f.isDirectory() ? 1 : 0, (long)f.getLastWrite());
    httpd_resp_send_chunk(req, zeile, n);
    erster = false;
    f.close();
  }
  d.close();
  httpd_resp_send_chunk(req, "]", 1);
  return httpd_resp_send_chunk(req, nullptr, 0);
}

// Datei oder ganzen Ordner loeschen. Eine Fahrt hat tausende Bilder -> in Portionen zu 32
static bool loescheAlles(const char* pfad) {
  File f = SD.open(pfad);
  if (!f) return false;
  bool ordner = f.isDirectory();
  f.close();
  if (!ordner) return SD.remove(pfad);
  for (;;) {
    String kinder[32];
    int anzahl = 0;
    File d = SD.open(pfad);
    for (File k = d.openNextFile(); k && anzahl < 32; k = d.openNextFile()) kinder[anzahl++] = String(pfad) + "/" + k.name();
    d.close();
    if (anzahl == 0) break;
    int geloescht = 0;
    for (int i = 0; i < anzahl; i++) if (loescheAlles(kinder[i].c_str())) geloescht++;
    if (geloescht == 0) return false;      // nichts ging -> nicht endlos weiterprobieren
  }
  return SD.rmdir(pfad);
}

// /datei?pfad=/fotos/foto_0001.jpg  herunterladen,  &weg=1 = loeschen (auch ganze Ordner)
esp_err_t karteDateiSenden(httpd_req_t* req) {
  char pfad[160], neu[80], neuPfad[200];
  bool loeschen = false;
  if (!da) { httpd_resp_send_err(req, HTTPD_404_NOT_FOUND, "keine SD-Karte"); return ESP_FAIL; }
  if (!holePfad(req, pfad, sizeof(pfad), &loeschen, neu, sizeof(neu)) || strcmp(pfad, "/") == 0) {
    httpd_resp_send_err(req, HTTPD_400_BAD_REQUEST, "pfad?");
    return ESP_FAIL;
  }
  if (loeschen) {
    bool ok = loescheAlles(pfad);
    Serial.printf(">> SD: %s %s\n", pfad, ok ? "geloescht" : "nicht geloescht");
    return httpd_resp_sendstr(req, ok ? "ok" : "fehler");
  }
  // &neu=Name: umbenennen (bleibt im selben Ordner). Antwort: neuer Pfad oder "fehler: ..."
  if (neu[0]) {
    if (!neuerName(pfad, neu, neuPfad, sizeof(neuPfad))) return httpd_resp_sendstr(req, "fehler: ungueltiger Name");
    if (SD.exists(neuPfad)) return httpd_resp_sendstr(req, "fehler: Name gibt es schon");
    bool ok = SD.rename(pfad, neuPfad);
    Serial.printf(">> SD: %s -> %s %s\n", pfad, neuPfad, ok ? "umbenannt" : "NICHT umbenannt");
    return httpd_resp_sendstr(req, ok ? neuPfad : "fehler: Umbenennen ging nicht");
  }
  File f = SD.open(pfad);
  if (!f || f.isDirectory()) { httpd_resp_send_err(req, HTTPD_404_NOT_FOUND, "nicht gefunden"); return ESP_FAIL; }
  const char* endung = strrchr(pfad, '.');
  const char* typ = "application/octet-stream";
  if (endung && !strcasecmp(endung, ".jpg")) typ = "image/jpeg";
  if (endung && !strcasecmp(endung, ".csv")) typ = "text/csv";
  if (endung && !strcasecmp(endung, ".wav")) typ = "audio/wav";
  httpd_resp_set_type(req, typ);
  char name[200];
  snprintf(name, sizeof(name), "%s; filename=\"%s\"", strcmp(typ, "image/jpeg") ? "attachment" : "inline", strrchr(pfad, '/') + 1);
  httpd_resp_set_hdr(req, "Content-Disposition", name);
  // grosse Stuecke (32 KB, im PSRAM) - je weniger Bloecke, desto schneller der Download
  const size_t N = 32 * 1024;
  uint8_t* puffer = (uint8_t*)heap_caps_malloc(N, MALLOC_CAP_SPIRAM);
  if (!puffer) { f.close(); httpd_resp_send_err(req, HTTPD_500_INTERNAL_SERVER_ERROR, "kein Speicher"); return ESP_FAIL; }
  esp_err_t ok = ESP_OK;
  size_t n;
  while (ok == ESP_OK && (n = f.read(puffer, N)) > 0) ok = httpd_resp_send_chunk(req, (const char*)puffer, n);
  heap_caps_free(puffer);
  f.close();
  if (ok == ESP_OK) ok = httpd_resp_send_chunk(req, nullptr, 0);
  return ok;
}
