ProD-byte/Roboauto/Codes/roboauto_pio/xiao_sense/include/zertifikate.h

#pragma once
// ============================================================
//  Stammzertifikate fuer HTTPS (Auto-Update von GitHub Pages).
//  Damit prueft das Auto, dass die Firmware wirklich von GitHub kommt
//  und unterwegs nicht ausgetauscht wurde.
//  Mehrere gaengige Stellen, falls GitHub den Aussteller wechselt:
//   - ISRG Root X1
//   - ISRG Root X2
//   - DigiCert Global Root G2
//   - DigiCert Global Root G3
//   - DigiCert Global Root CA
//   - USERTrust RSA Certification Authority
//   - USERTrust ECC Certification Authority
//   - Sectigo Public Server Authentication Root R46
//   - Sectigo Public Server Authentication Root E46
// ============================================================
const char UPDATE_ZERTIFIKATE[] = R"==(
-----BEGIN CERTIFICATE-----
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
-----END CERTIFICATE-----
-----BEGIN CERTIFICATE-----
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
/q4AaOeMSQ+2b1tbFfLn
-----END CERTIFICATE-----
-----BEGIN CERTIFICATE-----
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
MrY=
-----END CERTIFICATE-----
-----BEGIN CERTIFICATE-----
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
sycX
-----END CERTIFICATE-----
-----BEGIN CERTIFICATE-----
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
jjxDah2nGN59PRbxYvnKkKj9
-----END CERTIFICATE-----
-----BEGIN CERTIFICATE-----
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
-----END CERTIFICATE-----
-----BEGIN CERTIFICATE-----
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
-----END CERTIFICATE-----
-----BEGIN CERTIFICATE-----
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
-----END CERTIFICATE-----
-----BEGIN CERTIFICATE-----
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
-----END CERTIFICATE-----
)==";
