ProD-byte/Roboauto/Codes/roboauto_pio/src/kamera.cpp

#include <Arduino.h>
#include <esp_camera.h>
#include <esp_http_server.h>
#include <atomic>
#include <ESP32_OV5640_AF.h>
#include "config.h"
#include "kamera.h"
#include "medien.h"
#include "mikro.h"

// ============================================================
//  Kamera des XIAO ESP32S3 Sense (OV2640 oder OV3660).
//  Das Live-Video laeuft auf dem Medien-Server (Port 81) in einer eigenen Aufgabe -
//  so bremst es die Steuerung auf Port 80 nicht aus.
// ============================================================

static bool da = false;
static std::atomic<int> zuschauer{0};       // mehrere Browser = mehrere Aufgaben gleichzeitig
static int stufe = 1;
static volatile int fokusArt = -1;                   // -1 = kein Autofokus, 0 = laeuft dauernd, 1 = einmal scharf und fest
static OV5640 ov5640;

static const framesize_t GROESSEN[] = { FRAMESIZE_QVGA, FRAMESIZE_VGA, FRAMESIZE_SVGA, FRAMESIZE_HD };
constexpr int STUFEN = sizeof(GROESSEN) / sizeof(GROESSEN[0]);

bool kameraStarten() {
  camera_config_t k = {};
  k.pin_pwdn  = -1;   k.pin_reset = -1;   k.pin_xclk = 10;
  k.pin_sccb_sda = 40; k.pin_sccb_scl = 39;
  k.pin_d7 = 48; k.pin_d6 = 11; k.pin_d5 = 12; k.pin_d4 = 14;
  k.pin_d3 = 16; k.pin_d2 = 18; k.pin_d1 = 17; k.pin_d0 = 15;
  k.pin_vsync = 38; k.pin_href = 47; k.pin_pclk = 13;
  k.xclk_freq_hz = 20000000;
  // Kanal 7 / Timer 3: Motoren und Buzzer bekommen vom Arduino-Kern Kanal 0..4 und Timer 0..1
  k.ledc_channel = LEDC_CHANNEL_7;
  k.ledc_timer   = LEDC_TIMER_3;
  k.pixel_format = PIXFORMAT_JPEG;
  // Die Bildpuffer werden beim Start fuer diese Groesse angelegt -> gleich fuer die groesste Stufe (HD),
  // sonst laufen sie beim spaeteren Umschalten ueber. Danach wird auf die normale Stufe umgestellt.
  k.frame_size   = GROESSEN[STUFEN - 1];
  k.jpeg_quality = KAMERA_JPEG_QUALI;
  k.fb_count     = 3;                        // Live-Video und SD-Karte holen sich gleichzeitig Bilder
  k.fb_location  = CAMERA_FB_IN_PSRAM;
  k.grab_mode    = CAMERA_GRAB_LATEST;       // immer das neueste Bild (keine Verzoegerung)

  esp_err_t fehler = esp_camera_init(&k);
  if (fehler != ESP_OK) {
    Serial.printf(">> FEHLER: Kamera nicht gefunden (0x%x) - steckt das Sense-Board richtig?\n", fehler);
    return false;
  }
  sensor_t* s = esp_camera_sensor_get();
  if (s && KAMERA_DREHEN) { s->set_vflip(s, 1); s->set_hmirror(s, 1); }
  if (s) s->set_framesize(s, GROESSEN[stufe]);
  da = true;
  // OV5640: Autofokus-Firmware in den Sensor laden (ca. 4 KB, dauert gut 5 s) und scharfstellen lassen -
  // im Hintergrund, damit der Start nicht wartet. Bis dahin gilt "kein Autofokus" (fokusArt = -1).
  if (s && ov5640.start(s)) {
    xTaskCreate([](void*) {
      unsigned long t0 = millis();
      int art = -1;
      if (ov5640.focusInit() == 0 && ov5640.autoFocusMode() == 0) art = 0;
      fokusArt = art;
      Serial.printf(">> Kamera: Autofokus %s (%lu ms)\n", art == 0 ? "an" : "startet nicht", millis() - t0);
      vTaskDelete(nullptr);
    }, "autofokus", 4096, nullptr, 1, nullptr);
  }
  camera_sensor_info_t* info = s ? esp_camera_sensor_get_info(&s->id) : nullptr;   // OV2640, OV3660, OV5640 ...
  Serial.printf(">> Kamera bereit (Sensor %s)\n", info ? info->name : "unbekannt");
  return true;
}

bool kameraDa()          { return da; }
int  kameraZuschauer()   { return zuschauer; }
int  kameraAufloesungStufe() { return stufe; }

static int quali = KAMERA_JPEG_QUALI;
int kameraQualitaetWert() { return quali; }
void kameraQualitaet(int q) {
  if (!da) return;
  quali = constrain(q, 4, 40);
  sensor_t* s = esp_camera_sensor_get();
  if (s) s->set_quality(s, quali);
  Serial.printf(">> Kamera: JPEG-Qualitaet %d\n", quali);
}

void kameraAufloesung(int neu) {
  if (!da) return;
  stufe = constrain(neu, 0, STUFEN - 1);
  sensor_t* s = esp_camera_sensor_get();
  int r = s ? s->set_framesize(s, GROESSEN[stufe]) : -1;
  Serial.printf(">> Kamera: Aufloesung Stufe %d -> %s\n", stufe, r == 0 ? "ok" : "abgelehnt");
}

// Autofokus-Befehl an den Sensor schicken (wie in der Bibliothek: erst Quittung loeschen, dann Befehl)
static void fokusBefehl(uint8_t befehl) {
  sensor_t* s = esp_camera_sensor_get();
  if (!s) return;
  s->set_reg(s, OV5640_CMD_ACK, 0xff, 0x01);
  s->set_reg(s, OV5640_CMD_MAIN, 0xff, befehl);
}

int kameraFokusArt() { return fokusArt; }

void kameraFokus(bool fest) {
  if (fokusArt < 0) return;
  fokusArt = fest ? 1 : 0;
  // fest: jetzt einmal scharfstellen und die Linse dort lassen;  sonst: dauernd nachstellen
  fokusBefehl(fest ? AF_TRIG_SINGLE_AUTO_FOCUS : AF_CONTINUE_AUTO_FOCUS);
  Serial.printf(">> Kamera: Fokus %s\n", fest ? "einmal scharfstellen, dann fest" : "dauernd automatisch");
}

bool kameraScharf() {
  if (fokusArt < 0) return false;
  static unsigned long zuletzt = 0;          // Sensor hoechstens 4x pro Sekunde fragen
  static bool scharf = false;
  if (millis() - zuletzt > 250) {
    zuletzt = millis();
    // 0x10 = scharf (laut Anleitung); diese Firmware meldet nach dem Scharfstellen 0x20 - am Auto ausprobiert
    uint8_t z = ov5640.getFWStatus();
    scharf = z == FW_STATUS_S_FOCUSED || z == 0x20;
  }
  return scharf;
}

camera_fb_t* kameraBild() { return da ? esp_camera_fb_get() : nullptr; }
void kameraBildFrei(camera_fb_t* bild) { if (bild) esp_camera_fb_return(bild); }

// ---------- Seiten fuer den Medien-Server (medien.cpp) ----------
#define GRENZE "roboautobild"
static const char* STREAM_TYP   = "multipart/x-mixed-replace;boundary=" GRENZE;
static const char* STREAM_TRENN = "\r\n--" GRENZE "\r\n";
static const char* STREAM_KOPF  = "Content-Type: image/jpeg\r\nContent-Length: %u\r\n\r\n";

esp_err_t kameraStreamSenden(httpd_req_t* req) {
  if (!da) { httpd_resp_send_err(req, HTTPD_404_NOT_FOUND, "keine Kamera"); return ESP_FAIL; }
  if (zuschauer >= 2) {                        // mehr schafft das WLAN nicht fluessig - und haelt Verbindungen frei
    httpd_resp_set_status(req, "503 Service Unavailable");
    return httpd_resp_sendstr(req, "schon 2 Zuschauer");
  }
  httpd_resp_set_type(req, STREAM_TYP);
  httpd_resp_set_hdr(req, "Cache-Control", "no-store");
  zuschauer++;
  esp_err_t ok = ESP_OK;
  char kopf[64];
  while (ok == ESP_OK) {
    unsigned long start = millis();
    camera_fb_t* fb = esp_camera_fb_get();
    if (!fb) { delay(20); continue; }
    size_t n = snprintf(kopf, sizeof(kopf), STREAM_KOPF, (unsigned)fb->len);
    ok = httpd_resp_send_chunk(req, STREAM_TRENN, strlen(STREAM_TRENN));
    if (ok == ESP_OK) ok = httpd_resp_send_chunk(req, kopf, n);
    if (ok == ESP_OK) ok = httpd_resp_send_chunk(req, (const char*)fb->buf, fb->len);
    esp_camera_fb_return(fb);
    const long takt = mikroZuhoerer() > 0 ? KAMERA_STREAM_MIT_TON_MS : KAMERA_STREAM_MS;   // Ton hat Vorrang
    long rest = takt - (long)(millis() - start);   // Bildrate begrenzen (WLAN schonen)
    if (rest > 0) delay(rest);
  }
  zuschauer--;
  return ok;                                   // Browser hat die Seite verlassen
}

esp_err_t kameraBildSenden(httpd_req_t* req) {
  camera_fb_t* fb = kameraBild();
  if (!fb) { httpd_resp_send_err(req, HTTPD_500_INTERNAL_SERVER_ERROR, "kein Bild"); return ESP_FAIL; }
  httpd_resp_set_type(req, "image/jpeg");
  httpd_resp_set_hdr(req, "Content-Disposition", "inline; filename=roboauto.jpg");
  esp_err_t ok = httpd_resp_send(req, (const char*)fb->buf, fb->len);
  kameraBildFrei(fb);
  return ok;
}
