ProD-byte/Roboauto/Codes/roboauto_pio/xiao_sense/include/wlan_zugang.beispiel.h

#pragma once
// ============================================================
//  VORLAGE - kopieren als "wlan_zugang.h".
//  wlan_zugang.h wird NICHT zu GitHub hochgeladen (.gitignore).
//
//  Normalerweise einfach leer lassen: Das WLAN richtest du bequem
//  mit dem Handy ueber das Netz "Roboauto-Setup" ein.
// ============================================================
#define WLAN_NAME      ""
#define WLAN_PASSWORT  ""
