ProD-byte/Roboauto/(commit log)

2026-10-27 Online-Flasher: Update und Neuinstallation getrennt
2026-10-27 Schritt 30: 5 neue Chiptune-Lieder
    Neon-Jagd, Pixel-Galaxie, Turbo-Rennen (eigene Kompositionen), Wilhelm Tell und Hummelflug (gemeinfrei).
2026-10-27 Schritt 32: Disco-Lichter im Takt der Musik
2026-10-27 Schritt 37: 5 Kult-Chiptunes (JRPG, nene) + eigener Motor-Standard
2026-10-27 README: Credits fuer die neuen Chiptunes
2026-10-27 Schritt 38: 6 melancholische und traumhafte Stuecke
2026-10-27 Vorlaeufiger Schaltplan + Pin-Tabelle
2026-10-27 Schaltplan: Akku an Batterie-Pads, LEDs am 5V-Pin
2026-10-28 Aufraeumen: alte Code-Staende finalv5/finalv6 entfernt
    Der aktuelle Code liegt in Codes/roboauto_pio. Mit raus: eine doppelte
    .ino-Kopie und zwei Claude-Ablagebilder, die trotz .gitignore im Repo waren.
2026-10-28 Ordner aufgeraeumt: 3D-Druck, Modell, Platine
    - Aktuelle Druckteile in 3D-Druck/, Vorgaenger in 3D-Druck/alte Versionen/
    - Komplettmodelle in Modell/, Platine und Pinbelegung in Platine/
    - Fremde Modelle liegen lokal in Fremdteile/ (eine .gitignore-Zeile statt vieler)
    - README: neue Ordner, Link auf daveslab.de/basteln korrigiert
2026-10-28 Schaltplan fuer die XIAO-ESP32-C6-Variante (A3, SVG + PDF)
    Erzeugt mit Platine/schaltplan_xiao.py. Pinbelegung nach dem offiziellen
    Seeed-Pinout; Akkumessung an D0 (einziger ADC-faehiger freier Pin).
2026-10-31 XIAO ESP32S3 Sense: eigene Firmware mit Kamera, Mikrofon, SD-Karte
    - neuer Ordner Codes/roboauto_pio/xiao_sense (eigenes PlatformIO-Projekt)
    - alle LEDs an einem Pin (Ring -> Front -> Heck), Akku ueber MAX17048
    - Live-Video, Live-Ton, Klatschsteuerung, Lernen (Fahrdaten + Bilder auf SD)
    - GitHub Actions: Super Mini und XIAO als zwei unabhaengige Builds,
    XIAO-Dateien auf Pages unter /xiao/, eigene Karte im Online-Flasher
2026-10-31 Eigene Android-App statt Dabble (Test): Bluetooth + WLAN
    - Firmware: eigener BLE-Dienst (src/app_ble.cpp), Web- und App-Befehle laufen
    durch steuerBefehl() in web.cpp, neuer Befehl /info
    - Test-Umgebung env:roboauto_bletest (+ _wlan) ohne Dabble
    - Codes/roboauto_app: Android-App (WebView mit der Weboberflaeche aus
    webseite.h, Verbinden-Bildschirm, Bluetooth/WLAN in Kotlin)
    - Workflow app.yml baut die APK
    - Protokoll: Codes/roboauto_pio/docs/app-protokoll.md
2026-10-31 XIAO Sense: Weboberflaeche zeigt das Roboauto V7 (oben, Seite, Heck, Logo), LED-Ring scheint durch den Deckel
2026-10-31 App auf der Webseite zum Herunterladen (mit QR-Code), App-Build im Firmware-Workflow
2026-10-31 App: Fahrbefehle im WLAN per UDP statt HTTP
    Das Auto empfaengt Fahrbefehle zusaetzlich als UDP-Paket (Port 4211, gleiches
    Textformat wie Bluetooth) und meldet den Port in /info. Die App nutzt UDP, wenn
    das Auto es kann, sonst weiter HTTP; der Stopp geht dreimal raus. Dazu haelt
    ein Low-Latency-WifiLock das Handy-WLAN beim Fahren wach.
2026-10-31 Eigenes WLAN Roboauto zum Fahren ohne Router
    Das Auto oeffnet immer ein offenes WLAN Roboauto (AP neben dem Heim-WLAN,
    192.168.4.1). Die App hat dafuer einen Eintrag WLAN des Autos: ab Android 10
    wechselt sie per WifiNetworkSpecifier selbst hinein und bindet ihre Anfragen an
    dieses Netz, bei Android 8/9 ueber die WLAN-Einstellungen.
2026-10-31 Weboberflaeche: Fahransicht quer und aufgeraeumt fuers Handy
    - Handy quer: Joystick links, Knoepfe rechts, alles ohne Scrollen
    - Joystick passt sich der Bildschirmhoehe an
    - Touch: Tastatur-Hinweise ausgeblendet, Statuszeile mit Symbolen
    - Sprachwahl auf dem Handy in den Einstellungen
    - Akku-Diagramm in echter Groesse gezeichnet (Schrift nicht mehr gestaucht)
2026-10-31 Dabble entfernt: Roboauto-App ist die Steuerung
    Die normale Firmware (env:roboauto) nutzt jetzt den eigenen Bluetooth-Dienst
    der Roboauto-App statt Dabble. GamePad-Logik, lib/DabbleESP32 und die
    Test-Umgebungen roboauto_bletest* sind weg. Autos mit Auto-Update bekommen
    die App-Firmware automatisch. xiao_sense bleibt vorerst bei Dabble.
2026-10-31 Weboberflaeche: Scrollen auch auf Knoepfen
    Alle Knoepfe hatten touch-action:none, dadurch liess sich die Seite auf dem
    Handy nur am Rand scrollen. Jetzt touch-action:manipulation; nur die
    Halte-Knoepfe (Blinker, Hupe, Tank) und der Joystick sperren Wischen weiter.
2026-10-31 LED-Ring zeigt die Verbindungsart
    Bluetooth = Regenbogen, ueber den Router = tuerkiser Komet, direkt im WLAN
    Roboauto des Autos = gruener Komet. Beim Verbinden oder Wechsel zeigt der
    Ring die Farbe kurz als Signal, auch im Polizei- oder Team-Modus.
2026-10-31 xiao_sense: Roboauto-App statt Dabble
    Gleicher Stand wie das Hauptauto: eigener Bluetooth-Dienst (app_ble), ein
    gemeinsamer Befehlsverteiler fuer HTTP/UDP/Bluetooth inkl. Kamera und Karte,
    UDP-Fahrbefehle, eigenes WLAN Roboauto, Ringfarbe nach Verbindungsart,
    Scrollen auf Knoepfen. lib/DabbleESP32 und die GamePad-Logik sind weg.
2026-10-31 xiao_sense: Code fuer die Roboauto-App (Rest zum vorigen Commit)
    Der vorige Commit enthielt nur das Loeschen von lib/DabbleESP32. Hier folgen
    app_ble, Befehlsverteiler, UDP, Auto-WLAN, Ringfarben und Scroll-Fix.
2026-10-31 App aktualisiert sich selbst
    Die App prueft beim Start app.json auf GitHub Pages. Gibt es eine neuere
    Version, zeigt sie eine Update-Karte im Verbinden-Bildschirm und eine Pille in
    der Steuerung. Antippen laedt die APK und installiert sie ueber den
    PackageInstaller (ab Android 12 nach dem ersten Mal ohne Nachfrage).
    Ausserdem: WebChromeClient gesetzt, damit confirm()/alert() in der App gehen
    (z. B. Einstellungen zuruecksetzen).
2026-10-31 xiao-Kamera in der App, eindeutige Autonamen, 40 ms, Vibration
    - App bringt auch die XIAO-Oberflaeche mit (xiao.html) und waehlt sie nach
    /info "board"; Video/Ton/SD laufen ueber die Auto-Adresse (Roboauto.host),
    Medien-Server mit CORS und auch im Auto-WLAN gestartet
    - Bluetooth- und WLAN-Name mit Chip-Nummer: Roboauto-XXXX / RoboautoXiao-XXXX
    - Fahrbefehle alle 40 statt 80 ms, kurzes Vibrieren in der App
    - Auto-WLAN im Ring jetzt violett (gruen = Fahrweg abspielen)
    - GitHub-Actions auf aktuelle Versionen (Node-20-Warnung)
2026-10-31 Lenken durch Kippen des Handys (App)
    Knopf Kippen unter dem Joystick: Feld halten und Handy kippen, Nullpunkt beim
    Antippen, Loslassen = Stopp. App liefert die Schwerkraft in Bildschirm-Achsen.
    Doku: 40 ms, xiao-Kamera in der App.
2026-11-03 Ein Code fuer beide Autos + SD-Karte am Auto formatieren
    - XIAO Sense ins Hauptprojekt uebernommen: env:roboauto (Super Mini) und
    env:roboauto_xiao (XIAO) bauen aus Codes/roboauto_pio, XIAO-Teile der
    Webseite zwischen <!--XIAO--> Marken, Workflow angepasst
    - SD-Karte: exFAT-Karten werden erkannt ("unlesbar") und koennen auf der
    Webseite als FAT32 formatiert werden (Hintergrund-Aufgabe, Watchdog-Frist
    waehrenddessen 2 min); getestet am XIAO mit 128-GB-Karte
    - App: Play-Store-Variante (App-Bundle als eigenes Artefakt)
2026-11-03 XIAO: Live-Ton per Web Audio, Kamerabild drehbar (Standard 90 Grad links)
    - Chrome/Edge spielen den endlosen WAV-Strom im <audio>-Element nicht ab
    ("Format error") -> Seite holt den Ton per fetch und spielt ihn mit Web Audio
    - doppelten CORS-Header am Medien-Server entfernt (blockierte fetch)
    - neue Einstellung kamDreh (0/90/180/270, Standard 270 = 90 Grad links),
    Knopf "Drehen" auf der Webseite, gilt auch fuer die Foto-Vorschau
2026-11-03 XIAO: OV5640-Kamera - richtiger Sensorname, HD-Aufloesung 1280x720
    - Startmeldung nennt den echten Sensor (OV2640/OV3660/OV5640 ...)
    - neue Stufe 1280x720 HD; Bildpuffer werden fuer HD angelegt, damit das
    Umschalten nicht ueberlaeuft; Rueckmeldung im seriellen Monitor
    - getestet am XIAO mit OV5640: HD, 800x600, 640x480 schalten sauber um
2026-11-03 App: Live-Video und Ton vom XIAO durch die App reichen
    Die Seite kommt in der App von https://appassets... - den direkten
    http-Zugriff auf den Medien-Server des Autos (Port 81) blockiert die
    WebView, das Video flackerte nur. Jetzt holt die App Video, Ton,
    SD-Listen und Vorschaubilder selbst und reicht sie unter /medien/...
    durch. Download-Links gehen weiter direkt ans Auto.
2026-11-03 XIAO: Medien-Server ohne Speicherengpass, App-Video als Einzelbilder
    - Hauptursache fuers Flackern: jede lange Anfrage bekam eine neue 8-KB-
    Aufgabe aus dem internen RAM (nur noch ~9 KB frei) -> Server legte stumm
    auf. Jetzt 4 feste Arbeiter mit Stapel im PSRAM, Mikro + Lernen ebenso;
    hoechstens 2 Video-Zuschauer, sonst klare 503-Antwort
    - App: Video als Einzelbilder (/bild, ca. 10/s) statt MJPEG, Fehlergrund
    wird im Videofeld angezeigt
    - Kamera-Drehung Standard 0 Grad (passt fuer die OV5640), "Kamera aus"
    nicht mehr ueber dem laufenden Bild; freier interner Speicher beim Start
    - Belastungstest am XIAO: 6 Streams, Downloads/Ton/Einzelbild laufen weiter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
2026-11-03 Neustart-Grund und Absturzzaehler auf der Webseite (beide Autos)
    - neues Modul neustart: Grund des Starts, Abstuerze (Programmfehler,
    Watchdog, Spannungseinbruch) werden dauerhaft gezaehlt
    - /info liefert rst, lauf, abst, abstGrund; ?abstuerzeLoeschen=1 setzt zurueck
    - Einstellungen > System zeigt Grund + Laufzeit + Zaehler, nach einem
    Absturz erscheint oben eine Warn-Pille
2026-11-03 XIAO: Video bis ca. 20 Bilder/s, App liest den Strom selbst
    - Drossel von 15 auf ca. 22 Bilder/s (OV5640 schafft bei 640x480 gut 20)
    - App: MJPEG-Strom per fetch auslesen und Bild fuer Bild anzeigen
    (16 statt 8,6 Bilder/s im Test), Rueckfall auf Einzelbilder
    - JPEG-Qualitaet einstellbar (/kamera?quali=4..40), Standard bleibt 12
    - doppelte mDNS-Anmeldung entfernt ("Service already exists")
    - Grenze ist der feste TCP-Sendepuffer (5744 Bytes) bei langer Funklaufzeit
2026-11-03 XIAO: Video-Aufnahme (AVI mit Ton), Tagesordner und Dateiverwaltung
    - Videos als AVI (MJPEG ~22 Bilder/s + PCM-Ton 16 kHz, wenn Ton an ist)
    unter /videos/JJJJ-MM-TT/video_HH-MM-SS.avi; Knopf "Video" mit Laufzeit
    - Fotos unter /fotos/JJJJ-MM-TT/foto_HH-MM-SS.jpg
    - Uhrzeit per NTP im Heimnetz und vom Browser/App (/zeit), Zeitzone DE
    - Dateiverwaltung auf der Webseite: Fotos/Videos/Lernen, Tagesordner,
    sortieren, herunterladen, umbenennen (/datei?neu=), loeschen
    - Medien-Server: TCP_NODELAY, Downloads in 32-KB-Stuecken
2026-11-03 XIAO: Autofokus fuer den OV5640, Ton ohne Schnurren
    - Autofokus: beim Start die Fokus-Firmware in den OV5640 laden
    (Bibliothek 0015/OV5640 Auto Focus), dann dauernd scharfstellen;
    Knopf "Fokus" = einmal scharfstellen und festhalten / wieder automatisch,
    Haken = Sensor meldet scharf (/kamera?fokus=, Status af/afok)
    - Mikrofon: Gleichanteil per Hochpass Wert fuer Wert entfernen statt einmal
    pro Block - der Sprung alle 32 ms war als Schnurren zu hoeren
    - Webseite: Ton nach einer WLAN-Luecke weich einblenden statt Knacken
2026-11-03 Webseite und App nur noch auf Deutsch und Englisch
    - spanische und franzoesische Texte entfernt (Steuerseite und WLAN-Einrichtung)
    - war Spanisch/Franzoesisch gemerkt, gilt wieder die Handysprache (sonst Englisch)
    - README und Gesamtuebersicht angepasst
2026-11-03 Fahren mit Video: Cockpit-Ansicht quer (Webseite und App)
    - Knopf "Fahren mit Video" bei der Kamera: Vollbild mit Joystick links,
    Video mittig in voller Hoehe, Knoepfe rechts (Licht, Hupe, Foto, Video,
    Ton, Fokus) und Leiste mit Akku/WLAN; Kipp-Lenkung geht mit
    - Joystick und Video werden verschoben statt doppelt gebaut; Knopfgroesse
    passt sich dem Feld an
    - beim Einstieg hoechstens 640x480, beim Verlassen zurueck
    - ueber Bluetooth ausgegraut ("nur im WLAN")
    - App: Roboauto.cockpit() dreht fest ins Querformat und blendet Status-
    und Navigationsleiste aus; Zurueck-Taste verlaesst zuerst das Cockpit
2026-11-03 WLAN in der App ueber Bluetooth einrichten
    - Firmware (beide Autos): /netze (Netze in der Naehe, im Hintergrund gesucht)
    und /wlanspeichern?n=&p= (merken + Neustart) - nur ueber Bluetooth
    - Webseite/App: Bereich "WLAN einrichten" mit Netzliste (Schloss, Signal,
    gespeichert), Passwort, Name von Hand; wartet nach dem Neustart auf die
    WLAN-Verbindung und bietet "Auf WLAN wechseln" an
    - Hinweis oben, solange das Auto per Bluetooth verbunden und in keinem WLAN ist;
    "WLAN aendern" oeffnet ueber Bluetooth diese Einrichtung
2026-11-03 WLAN-Einrichtung per Bluetooth: Suche zuverlaessig, schnellerer Start
    - /netze merkt sich das Ergebnis (die eigene Suche im Einrichtungsmodus
    ueberschrieb es) und startet keine Suche doppelt
    - Seite wartet bis zu 45 s mit Sekundenanzeige; alte Firmware ohne den Befehl
    wird erkannt ("Auto zuerst aktualisieren")
    - Befehle auch ueber das USB-Kabel (Fehlersuche): eine Zeile wie "/netze"
    - XIAO: Autofokus-Firmware im Hintergrund laden - Start 3 statt 8 s
2026-11-04 WLAN-Einrichtung: verbundenes Netz gruen markieren
    - /netze meldet "v":1 fuer das Netz, mit dem das Auto gerade verbunden ist
    - Netzliste zeigt es mit "verbunden", gruenen Streifen und gruenem Rahmen
    - nach erfolgreicher Einrichtung laedt die Liste von selbst neu
2026-11-10 XIAO: Akkuwaechter MAX17043, LED-Kette per DMA, Doku korrigiert
    - Akkuwaechter: MAX17043 wird erkannt (Spannung anders gezaehlt, keine
    Raten-Register - die Laderate rechnet die Firmware aus dem Ladestand)
    - LED-Kette (XIAO): Ausgabe per RMT mit DMA statt Adafruit show() -
    ohne Nachfuell-Luecken bei Last durch Kamera/WLAN; Rueckfall auf show()
    - Doku: N20-Motoren 3 V / 500 U/min; Vorwiderstand und Kondensator sitzen
    schon auf den LED-Platinen
2026-11-10 Doku XIAO: LED-Kette an LiPo-Plus hinter dem Schalter
    Der 5V-Pin des XIAO hat nur Spannung, solange USB steckt; an 3V3 leuchtet
    nur die erste LED. Die LED-Kette kommt deshalb an BAT+ hinter dem Schalter.
2026-11-10 Super Mini entfernt - nur noch XIAO ESP32-S3 Sense
    - Firmware: Umgebungen roboauto/roboauto_wlan und alle ROBOAUTO_XIAO-Weichen
    entfernt, akku.cpp (Spannungsteiler) geloescht, LED-Kette als eine Kette
    - Webseite: XIAO-Markierungen weg, webseite_gz.py ohne Board-Auswahl
    - App: nur noch eine Steuerseite (index.html)
    - GitHub: Build-Job mini und Mini-Flasher entfernt; Firmware bleibt unter
    /xiao/, damit das Auto-Update der Autos weiter funktioniert
    - Doku: README, Gesamtuebersicht und xiao-sense.md auf den XIAO umgeschrieben,
    alte Mini-Schaltplaene entfernt, Platine = XIAO ESP32-S3 Sense (nicht C6)
2026-11-10 Akkuwaechter: Laden auch an steigender Spannung erkennen, I2C-Pruefbefehle
    - MAX17043: steigt die Spannung um mind. 5 mV/min, gilt der Akku als
    ladend - ganz unten im Akku bleibt der Ladestand lange stehen
    - Fehlersuche ueber WLAN/USB/Bluetooth: /i2c listet die Geraete am I2C-Bus
    (?tausch=1 mit vertauschten Leitungen), /pintest?nr=5|6 prueft einen
    I2C-Pin mit Pull-up, Pull-down und als Ausgang
2026-11-10 Akkuanzeige: beim Laden Blitz und Prozent statt nur "USB"
    - "⚡ 37 %" waehrend der Akku laedt, Balken zeigt den echten Ladestand
    - Tooltip "laedt · 3578 mV"; nur "USB", wenn kein Akkuwaechter misst
    - gilt auch fuer die Leiste im Cockpit (Fahren mit Video)
2026-11-10 LED-Ring zeigt beim Laden den Ladestand
    - laedt der Akku (Akkuwaechter misst) und steht das Auto seit 3 s:
    Balken bis zum Ladestand (rot -> gelb -> gruen), naechste LED atmet,
    alle 3 s laeuft ein heller Punkt hoch; voll = ganzer Ring ruhig gruen
    - Alarm, Signal, Musik und Aufnahme haben weiter Vorrang; sobald das
    Auto faehrt, kommt die normale Anzeige
2026-11-10 Ladeanzeige: Aufhellung in Balkenfarbe statt weissem Punkt
    - kein Weiss mehr (spart Strom beim Laden, die LEDs haengen am Akku)
    - Aufhellung bleibt im gefuellten Teil, unter 12,5 % atmet nur die erste LED
    - volle LEDs etwas dunkler (50 %)
2026-11-14 App: Update ab Android 12 von selbst installieren
    Findet die App beim Start eine neuere Version und ist noch kein Auto
    verbunden, laedt und installiert sie sie ohne Antippen (still, sobald die
    App selbst als Installierer gilt). Mit verbundenem Auto bleibt es beim
    Antippen der Pille, damit die App beim Fahren nicht neu startet.
2026-11-14 App: Verbinden-Bildschirm nur noch Deutsch und Englisch
    Spanische und franzoesische Texte entfernt; andere Handysprachen
    bekommen Englisch (wie die Steuerseite).
